lirushirealone/sensor-lossless-fpga/report/ai_collaboration.md

# 大模型协作记录

真实交互见[原话摘录](ai_records/records.md)和[结构化记录](ai_records/records.json)。共10个案例，覆盖计时归因纠错、返回复制、双缓冲所有权、世代回绕、提频失败、紧凑令牌取舍、统一候选夹具修正、CMA验收修订、跨平台源码复现和独立安装。每个案例关联可见用户指令、模型回答及实际验证证据。

摘录通过开发聊天的历史读取接口取得，包含用户提示词和对用户可见的模型原话；不是事后编写的问答，也不是完整聊天全集。私人文件引用已标注省略，账号凭据、个人升学聊天、签名及人员资料未纳入。上下文、经验提炼、验证索引为本轮整理内容，与原话分开。历史模型确切版本未在可见消息中保存，不作推断。

[evidence/collaboration/index.json](../evidence/collaboration/index.json)登记历史实验的原文件SHA256；附带历史报告和独立核验JSON保持原字节。记录中的中间数值或目标可能在后续被撤回，应以案例结论和对应测量边界为准。source-v3更新文档与技能材料；source-v4另补齐正式设计报告及小写命名，不代表重新上板或重做布局布线。

可复用技能与边界见[skill/readme.md](../skill/readme.md)。整理后的提示词模板标注为派生模板，不冒充当时原话；通用PYNQ加分是否成立仍由赛事评审判断。
