lirushirealone/sensor-lossless-fpga/report/limitations.md

# 已验证范围和限制

- 工程用于PYNQ-Z2 / xc7z020clg400-1，公开数字传感文件回放；未集成实体ADC连续采集。
- 预构建bit、RTL和固定源样本哈希可核对。历史板端验证与本轮源码包运行检查必须分别引用。
- 完整候选统一版对代表记录比旧快速版增加约29%至48%墙钟；不宣传整机加速。
- 历史新MIT-BIH/ECG-ID记录与旧55记录统计范围不同；重复回放不增加独立数据数量。
- 历史30分钟确认的本进程映射释放与RSS门槛有记录，但全局CmaFree下降2652KiB、原1024KiB阈值未通过，来源仍未完全定位。不能宣称排除所有内核泄漏。
- 原始回退保留头开销，短文件可能扩大；大块提高压缩空间也增加等待，不承诺实时性或未知输入压缩率。
- 无真实功耗、ASIC综合或PPA结果；不把资源数量当作运行忙碌率。
- 跨板卡、其他工具/系统版本未全部验证；重建需用户合法安装Vivado及PYNQ环境。
- 本包不包含正式比赛视频、签署授权书、实物照片或最终技术报告PDF；这些仍需单独完成。
