lirushirealone/sensor-lossless-fpga/report/ai_records/records.md

# 大模型协作原始交互摘录

本文件提供10个技术案例的真实用户提示词、模型可见回答和纠错过程，供评审核查。记录摘自开发聊天，属于经筛选的原始交互，不是完整聊天全集。只隐去本机文件引用；未补写、润色或重构历史原话。上下文和经验总结为2026年11月1日整理文字。消息编号、原文指纹、脱敏规则和公开文本指纹见同目录records.json。模型历史版本未在可见消息中保存，不推测具体型号。

用户多次用“知道了”启动已约定的下一阶段，这些简短提示词按原样保留，技术目标以同一案例的模型计划与后续记录补足。记录只含用户和模型对用户可见的文字，不含内部推理。历史数字保留原测量日期和口径，不能当作本轮重新上板成绩。

## c01 计时边界与未经测量的收益归因

原会话日期：2026-10-19。上下文：用户粘贴了另一AI的性能分析，要求核对；其中的数字和预测并非本项目已经确认的事实。

### 1 用户原话（用户粘贴的其他AI分析，包含后续被纠正的说法）
消息编号：`01a1532f-aa7f-7d32-90a1-63d1bae9a951`。未改写原文。

> 常规版 **direct-frame-v1**（1024 点）和最新实验 **lz77-input-v1 / lz77-hw-v2**（8192 点），v1 以及 compact-delta 之前的版本没有做分析。结论先说：**算法本身已经不是瓶颈，问题出在“搬运”上——为了搬走 5.2ms 的匹配计算，系统付出了 1.7ms 的 DMA 往返和 3.2ms 的回传再编码。**
> 
> ## 一、当前每块的实际开销（BIDMC 49 份，1568 块，8192 点/块）
> 
> | **阶段**     |  **ms/块** | **占比** | **说明**                              |
> | ---------- | --------: | -----: | ----------------------------------- |
> | 输入准备       |      3.53 |    24% | list→int16 快照 + CRC + 命令数组          |
> | DMA 往返     |      1.72 |    12% | 传输 + 缓存维护 + 轮询，**不含** FPGA 计算       |
> | FPGA 匹配    |      5.22 |    35% | 260,784 拍 @50MHz                    |
> | 令牌 Huffman |      3.16 |    21% | `lz_pack` + 32KB 令牌回传               |
> | 组帧/校验/统计   |      1.18 |     8% | metadata 两次 CRC + profile 20 次 MMIO |
> | **合计**     | **14.81** |        | 纯 ARM 对照 **10.73**                  |
> 
> 拆开 FPGA 那 5.22ms：清空头表 0.66ms（32,768 拍，占 12.6%）、125,699 次探测 2.51ms（48%）、哈希/状态机/跳过 2.05ms（39%）。
> 
> **关键对照**：纯 ARM 扣掉同样 3.53ms 的准备后是 7.20ms；FPGA 路径扣掉准备后是 11.28ms。也就是说，FPGA 搬走了 5.2ms 的匹配，却额外带来 4.9ms 的往返和二次编码——**净亏 4ms**。这正是它现在为 ARM 的 1.21～1.39 倍的真实原因。
> 
> ## 二、按性价比排序的优化项
> 
> **1. 令牌编码 3.16ms/块（最值得先动）** `lz77_pack_native.c:21,37` 每块都执行 `deflateInit2` → `_tr_flush_block` → `deflateEnd`。但这条路径只做 tally 和 Huffman，根本不做匹配，`lm_init` 里那 64KB 头表清零完全是浪费；而且每块重新 calloc 一份 \~264KB 的 deflate_state。 改法：复用一份 `deflate_state`，只重置 tally/pending（或自己维护 tally 数组直接调 `build_tree`）。另可把令牌从 4B/个改成变长 ≤2B，输出 DMA 直接减半。 预期：3.16 → 0.5～1ms，省 2～2.7s。风险低，只要保持逐字节等于现有输出（有 55 份冻结文件可以逐字节回归）。
> 
> **2. DMA 批处理，1.72ms/块** 1568 块 × 1.72ms = 2.7s 纯开销。改成 8 块一次事务（输入 128KB、令牌 ≤256KB，CMA 从 98KB 扩到 \~512KB 即可），或者直接上 SG 描述符链。 预期：2.7s → \~0.4s。代价是 RTL 要支持连续命令，现有那套 4 类故障恢复测试正好复用。
> 
> **3. 双缓冲重叠** 现在是严格串行：提交 → 等完 → 才编码。编码那 3.16ms 完全可以藏在下一块 5.2ms 的匹配后面。改完顺序流水后，单块等效时间 ≈ 准备 + max(匹配, 编码) + 帧。 预期：最多省 4.9s，是所有软件项里收益最大的一条。
> 
> **4. 头表 epoch 懒清零（RTL 小改）** `lz77_matcher.sv:141-144` 每块清 32768 项，固定 32,768 拍 = 0.66ms/块。v2 README 第 20 行自己也写了“本次未改为带 epoch 的懒清表”。给 heads 加几 bit 世代号，读时比对、不匹配当 NIL，写时打当前世代。 预期：省 12.6% 的匹配时间，输出字节完全不变。改动小、风险低，是 RTL 侧性价比最高的一项。
> 
> **5. 输入准备 3.53ms/块** `lz77_input.py:23` 的 `array.array('h', values)` 是逐元素转换；如果上游给的是 numpy 标量组成的 list，会全部走 `__index__` 慢路径（板上实测 0.43µs/点，PC 上同类操作 0.012µs/点）。真实 ADC 流本来就该是 bytes/ndarray，直接用 `<i2` 视图即可。 预期：3.53 → 0.3～0.5ms（省 5s）。**注意**：纯 ARM 对照用的是同一个 `snapshot()`，所以这项不改变“FPGA vs ARM”的结论，只是把两边绝对值一起拉低。
> 
> **6. 把时钟提上去（收益最大、工作量也最大）** 50MHz、WNS 只有 0.070ns，等于贴着时序过。关键路径几乎肯定是 8 个 bank 的 128 位组合移位 + 8 lane 比较。把 rotate 打一拍、或用 8 个 8:1 mux 替掉 barrel shift，目标 80～100MHz。 预期：按 1.4～1.7 倍折算，匹配 5.22 → 3.1～3.7ms。这条要和 1、2、3 叠加才有意义，单独做不够。
> 
> **7. 顺手能砍的测试耗时（不影响产品，但影响迭代速度）** `validate_lz77_input.py:65` 的 `sum((int(v)&0x80000000)!=0 for v in tokens)`、`lz77_protocol.expand()` 都是逐 token/逐字节的 Python。55 份记录一整轮 367s，其中真正分支时间只有 23s——15 倍都花在验证上。改成 numpy 掩码、expand 只抽样，一轮能从 6 分钟压到 1～2 分钟。
> 
> ## 三、不建议现在动的
> 
> - **降低探测预算、按历史跳过候选**：candidate-gate-v1 已经证明会改变输出字节，且收益不稳定。
> - **8192 退回 1024**：直接丢 9.6 个百分点压缩率，还把 32 位窗口优势让掉。
> - **固定 Huffman**：8192 点下波形从 61.3% 掉到 54.8%，得不偿失。
> 
> ## 四、一个更大的方向（建议下一阶段单独做）
> 
> 现在每块独立、跨块不共享历史，所以每块都要清表、也拿不到跨块匹配。改成 **16KB 滑动窗口的连续流**：8192 点不用再攒 65.5 秒才成一块（实时性解决），压缩率还能再涨一截，清表成本也自然消失。代价是匹配器位置要改成 mod 16384、令牌格式变、不能再和 zlib6 逐字节对齐——验证基准得重建。不要和本轮优化混在一起做。
> 
> ## 五、建议的执行顺序
> 
> 1. **先剖析**：在板上单独给 `lz_pack` 计时 100 次，确认那 3.16ms 到底是 C 初始化、Python/ctypes，还是 32KB 输出拷贝。
> 2. epoch 懒清表（sim 已有 237 块回归，最稳）。
> 3. DMA 8 块批量。
> 4. 双缓冲。
> 5. 输入准备。
> 6. 时钟/流水。看看其他ai给你分析的

### 2 模型可见原话
消息编号：`msg_02837f5fda74b726016ad5cec61c7887d0966cbfea72d52f72`。未改写原文。

> 我先把这份分析与现有代码、板上记录逐项核对，重点检查计时是否重叠、收益估算是否成立，再判断哪些建议值得先做。

### 3 模型可见原话
消息编号：`msg_02837f5fda74b726016ad5cf01c97887d0b461aa9e50d81516`。未改写原文。

> 核对后，逐块初始化编码器、双缓冲、清表这些优化方向有依据。但几处数字需要修正：5.22ms是FPGA整包时间，包含收数和输出；所谓1.72ms“纯DMA开销”只是两个计时区间相减，尚未单独测量。另外，按当前32位传输格式，8块批量的输入和最坏输出都会超过现有DMA单次长度上限。

### 4 模型可见原话
消息编号：`msg_02837f5fda74b726016ad5cf6d14cc87d0b471ab861c5b0415`。已隐去本机文件引用。

> 我核对了源码和原始板上记录。**这份分析提出的优化方向值得采纳，但部分计时解释、容量计算和预期收益需要纠正。最值得先做的，仍然是细分令牌编码的耗时。**
> 
> **首先，14.81ms这个总数正确，但内部不能按它的方式解释。**
> 
> 我重新汇总了49份BIDMC、1568块的记录：
> 
> | 阶段 | 平均ms/块 | 目前能确认的含义 |
> |---|---:|---|
> | 输入准备 | 3.525 | 快照、原值CRC、命令数组 |
> | DMA提交至完成 | 6.943 | **包含FPGA处理过程**，以及启动、等待等 |
> | 令牌编码调用 | 3.163 | 参数检查、C编码器、返回结果转换 |
> | 最终组帧 | 0.068 | 生成完整压缩帧 |
> | 其余驱动处理 | 1.109 | 根据总时间计算出的剩余区间，尚未进一步拆开 |
> | **完整分支** | **14.809** | 纯ARM对照为10.728 |
> 
> 依据是原始板上记录 [本机文件路径已省略]。
> 
> 这里有三个关键修正：
> 
> - **5.22ms是FPGA整包时间**，包含收数、匹配和输出；匹配器自身记录的工作时间约为 **4.69ms**。
> - **1.72ms只是“主机提交至完成时间－FPGA整包时间”**。两个计时边界不同，还没有证据把差值全部叫作纯DMA开销，更不能认为批量传输能消掉其中七分之六。
> - 纯ARM中的匹配尚未单独计时，因此“搬走了ARM的5.2ms计算”不成立。我们确认的是完整分支目前多花约 **4.08ms**，具体原因还需拆分。
> 
> 另外，8192是最大块长；这些记录包含尾块，平均约7500点/块。
> 
> **逐项看，我会这样判断。**
> 
> | 建议 | 我的判断 |
> |---|---|
> | **复用Huffman编码器状态** | **优先验证。** 每块确实重新初始化、分配和释放。可以研究复用状态，但要完整重置编码树、位缓存和输出状态，保持各块独立，不能只清两个计数器。 |
> | **压缩令牌传输格式** | 有潜力，但“每个令牌都≤2字节”不能直接保证。匹配令牌需要同时表示长度和距离，通常需要更长表示或额外上下文；这属于协议修改。 |
> | **DMA批处理** | 值得研究，但原容量估算有误，不能直接照做。 |
> | **双缓冲重叠** | **值得优先推进。** 可以让ARM编码上一块，同时让FPGA处理下一块；实际收益需计入启动、收尾和内存竞争。 |
> | **epoch懒清表** | 有明确依据，但收益上限比描述中有限，且需要处理初始化、世代号回绕和异常复位。 |
> | **输入改用ndarray/bytes** | 方向合理。当前已经有整数ndarray快路径，下一步应检查上游为何仍生成list，并让两种对照使用相同输入条件。 |
> | **提高时钟** | 可以做，须依据真实关键路径修改；80～100MHz目前只是目标。 |
> | **加快验证** | 可以优化验证实现，但正式验收应继续完整核对，不能用抽样替代全部逐点验证。 |
> 
> 其中有几个具体问题值得展开。
> 
> **1. 编码阶段还存在一个它没有明确指出的可疑开销。**
> 
> 当前返回结果使用：
> 
> ```python
> bytes(self.output[:self.size.value])
> ```
> 
> 这里对`ctypes`字节数组切片，会先形成Python整数列表，再转换成`bytes`。可以比较直接复制指定长度的字节，例如`ctypes.string_at`，避免这个中间列表。代码位置见令牌消费者 [本机文件路径已省略]，相关接口见[Python官方文档](https://docs.python.org/3/library/ctypes.html#ctypes.string_at)。
> 
> 所以，**先测清楚3.16ms分别花在初始化、实际编码和返回转换上，再决定改哪部分**。“降到0.5～1ms”目前没有实测依据。
> 
> 这3.16ms也不包含之前的DMA令牌回传，不能把两者混算。
> 
> **2. 8块批量的容量确实算少了。**
> 
> 按当前协议，输入样本虽然是16位，但每个样本占一个32位传输字：
> 
> - 8块输入：**262,176字节**。
> - 8块最坏输出：**524,544字节**。
> - 现有18位DMA单次长度上限：**262,143字节**。
> 
> 所以输入已经略超上限，输出更明显超限；输入加输出缓冲约需 **768KiB**，还没算双缓冲。需要同时调整DMA长度、协议、缓冲和恢复流程，不能只扩大CMA。
> 
> **3. 懒清表值得做，但不能承诺轻松获得很大提升。**
> 
> 每块清32768项确实耗时约 **0.655ms**。对这1568块，全部消除的理想收益约为 **1.03秒**，占完整分支约 **4.4%**。
> 
> 此外，“125,699次探测＝125,699拍”不成立：一次候选探测可能比较多个8字节窗口，**探测次数不是探测周期数**。因此它对FPGA内部时间的拆分还不是实测结论。
> 
> **4. 连续滑动窗口可以探索，但不会自动解决实时性。**
> 
> 历史窗口与输入分块可以分开设计，小批次输入也可以保留历史。要缩短等待，还需明确输出周期、动态Huffman何时结束当前块，以及解码检查点。频繁刷新输出可能损失压缩效果；跨块引用也会改变当前逐块独立解码的能力。[DEFLATE规范](https://www.rfc-editor.org/rfc/rfc1951.html#section-2)、[zlib刷新说明](https://www.zlib.net/manual.html)。
> 
> 不能提前保证压缩率一定再涨多少。
> 
> **我建议调整后的执行顺序是：**
> 
> 1. **拆分令牌编码耗时**：初始化、校验、实际Huffman、结果返回。
> 2. **先处理已确认的软件浪费**：中间列表、重复分配、可安全复用的状态。
> 3. **拆分DMA及驱动收尾耗时，实施双缓冲重叠。**
> 4. **做epoch懒清表**，单独验证效果与资源变化。
> 5. 根据剩余瓶颈，再决定批量DMA、输入格式和时钟流水优化。
> 
> 这份分析最值得采纳的是具体优化线索；**“问题已经确定全在搬运上”和各项预计节省多少秒，目前都还不能作为结论。**

### 验证与经验提炼

把整包周期、匹配工作周期、主机调用和墙钟分别定义；不能由重叠区间之差推导纯DMA开销。

证据：`evidence/collaboration/lz77-entropy-v1/report.md`；`evidence/collaboration/lz77-entropy-v1/verification.json`。

## c02 令牌返回复制与先测后改

原会话日期：2026-10-19。上下文：此前已明确先拆分令牌编码耗时；本轮“开始”是对该步骤的启动指令。

### 1 用户原话
消息编号：`01a1533a-05c5-7010-a241-396f6aa9e229`。未改写原文。

> 所以第一项就是令牌编码？如果是的，请直接告诉我，在我答复之后直接开始进行优化

### 2 模型可见原话
消息编号：`msg_02837f5fda74b726016ad5d1732d9c87d0a5f2ef495072c8f8`。未改写原文。

> 是的，先做**令牌编码环节的计时与优化**：测清结果复制、重复初始化和实际编码的耗时，再优化最贵的部分，保持压缩效果和无损校验不变。
> 
> 你回复后，我就直接开始。

### 3 用户原话
消息编号：`01a1533a-8cae-78f2-9226-4f4fcc95118e`。未改写原文。

> 开始

### 4 模型可见原话
消息编号：`msg_02837f5fda74b726016ad5d190dfac87d0aefee1a7220fc700`。未改写原文。

> 我先在板卡上拆分令牌编码的耗时，比较几种结果复制方式，再根据实测优化。新实现会放在独立版本中，并与现有压缩文件逐字节核对。

### 5 模型可见原话
消息编号：`msg_02837f5fda74b726016ad5d2831fd087d0930648dad65b9159`。未改写原文。

> 板卡已连通。我正在用之前保存的真实FPGA令牌做编码测试；这一步不需要重新加载硬件设计。除了比较复制方式，也会分别测量初始化、令牌检查、频次统计、Huffman编码和结果返回。

### 6 模型可见原话
消息编号：`msg_02837f5fda74b726016ad5d2af425087d0aa581f1a0a8a8430`。未改写原文。

> 实测发现，结果返回时生成Python列表，约占代表片段令牌编码时间的一半；初始化和释放只占很小一部分。仅改为直接复制字节，三组片段的令牌编码耗时已减少约45%～51%。我接下来把这项改动接入板上流程，核对完整压缩耗时和输出一致性。

### 7 模型可见原话
消息编号：`msg_02837f5fda74b726016ad5d44af3fc87d0ad63a44ddb5b83bb`。未改写原文。

> 电脑端55份数据已全部通过，优化前后的完整压缩文件逐字节相同。板上也正在逐份通过。此次保留原有令牌检查、编码选择和CRC，只替换结果返回方式；全量验证后，还会用新旧版本交替运行，确认完整流程实际能省多少时间。

### 8 模型可见原话
消息编号：`msg_02837f5fda74b726016ad5d50dfa1c87d0a05e3bd024580a48`。未改写原文。

> 板上55份数据已全部通过，38组边界数据和4类故障恢复也通过了。目前正在做7轮交替测速，之后会把实际输出下载到电脑独立核验，并恢复原来的常规版本。

### 9 模型可见原话
消息编号：`msg_02837f5fda74b726016ad5d579331887d0a8005bdfb21b1019`。未改写原文。

> 完整流程的7轮测速已完成：家庭电力、家电和波形三组片段的耗时分别减少13.6%、7.2%和10.9%。55份压缩文件下载后也全部核验一致。新分支仍比同条件的纯ARM慢约9.7%～22.2%；我正在保存报告，原常规版本已恢复并确认可用。

### 10 模型可见原话
消息编号：`msg_02837f5fda74b726016ad5d5b8a78487d080cfe69f8aec9929`。已隐去本机文件引用。

> **已完成令牌编码的第一轮优化，并通过上板验证。**
> 
> 主要浪费来自返回结果时生成Python整数列表。改为直接复制字节后，令牌编码耗时减少 **42.9%～49.7%**，压缩效果保持不变。
> 
> 同板7轮交替测试，完整分支结果：
> 
> | 代表片段 | 优化前 | 优化后 | 耗时减少 |
> |---|---:|---:|---:|
> | 家庭电力 | 64.12ms | 55.43ms | **13.56%** |
> | 家电 | 27.94ms | 25.93ms | **7.20%** |
> | 波形 | 66.25ms | 59.01ms | **10.93%** |
> 
> 55份数据、约1197万点全部无损还原，完整压缩文件逐字节一致；边界和故障恢复测试也通过。
> 
> 实测初始化与释放仅占原编码环节约0.9%～1.8%，因此C状态复用顺延。**新分支仍比同条件纯ARM慢约9.7%～22.2%**，下一步应细分DMA和驱动收尾成本。
> 
> 新实现保存为独立版本 `lz77-entropy-v1`，原常规版已恢复。完整实测报告 [本机文件路径已省略]

### 验证与经验提炼

微基准先定位返回列表，七轮完整分支再确认收益；初始化复用不因先验猜测进入生产路径。

证据：`evidence/collaboration/lz77-entropy-v1/report.md`；`evidence/collaboration/lz77-entropy-v1/verification.json`。

## c03 双缓冲与结果所有权

原会话日期：2026-10-19。上下文：用户按既定逐步计划回复“知道了”；随后开始双缓冲阶段。

### 1 用户原话
消息编号：`01a15400-8015-7581-95af-ec906340aa37`。未改写原文。

> 知道了

### 2 模型可见原话
消息编号：`msg_02837f5fda74b726016ad6043d42cc87d086430ea647e862e3`。未改写原文。

> 我开始下一项：双缓冲与异步调度。先确认哪些工作可以安全重叠，再让下一块的 FPGA 计算与上一块的 ARM 编码同时进行；完成板测和异常恢复验证后，我会汇报并停下。

### 3 模型可见原话
消息编号：`msg_02837f5fda74b726016ad604de677487d0972bda3782420d71`。未改写原文。

> 现有硬件一次只能处理一笔 DMA，所以这一轮不会同时启动两个压缩任务。实现上会用两组缓冲轮换：先完整取回并校验第 N 块，再启动第 N+1 块，让 ARM 趁这段时间编码第 N 块；同时检查缓冲复用和中断后的释放顺序。

### 4 模型可见原话
消息编号：`msg_02837f5fda74b726016ad6063ea93487d0a26d529f164b9efa`。未改写原文。

> 电脑端已通过 10 组调度与生命周期测试，包括禁止重复提交、旧结果在缓冲复用后仍有效、编码或输出出错时取消后续任务。55 份数据的完整文件比对也通过了。现在正做小规模板测，确认真实 DMA 下的重叠和恢复行为。

### 5 模型可见原话
消息编号：`msg_02837f5fda74b726016ad606fcd70887d085d7e7fb75e84b7c`。未改写原文。

> 小规模板测通过了：三种调度方式生成的文件完全一致，也实际观察到了“下一笔 DMA 尚未完成，ARM 已开始编码上一块”。重叠版暂时比串行版快，但首块输出略晚；完整板测会同时记录吞吐、首末块延迟，以及双缓冲增加的内存占用。

### 6 模型可见原话
消息编号：`msg_02837f5fda74b726016ad607f6bcc087d0b28c37710f12a4b3`。未改写原文。

> 55 份真实数据已经全部通过，压缩结果没有变化。现在正在验证新增的流水异常场景，包括编码失败、输出回调失败和中断时取消下一笔 DMA。之后会用相同输入比较旧串行、拆分接口后的串行，以及双缓冲重叠三种方式，区分接口开销和重叠带来的收益。

### 7 模型可见原话
消息编号：`msg_02837f5fda74b726016ad608c0b51887d090f749872f1d2a31`。未改写原文。

> 独立核验通过了。双缓冲让三个代表记录的完整流程耗时再减少 **18.74%～22.01%**；其中 `bidmc01` 波形记录比同条件纯 ARM 少用约 **12.1%** 时间，另外两类仍慢于 ARM。压缩文件字节保持不变，代价是多用约 96 KiB 缓冲，首块输出晚约 1 ms。

### 8 模型可见原话
消息编号：`msg_02837f5fda74b726016ad608f7251487d0be2da2d4893f1164`。已隐去本机文件引用。

> **双缓冲与异步调度已完成，并通过板测。**现在 FPGA 处理下一块时，ARM 同时编码上一块。
> 
> 同板七轮测试，三个完整代表记录的耗时：
> 
> | 数据 | 原串行 | 双缓冲 | 耗时减少 |
> |---|---:|---:|---:|
> | 家庭电力 | 57.27 ms | 45.59 ms | 20.39% |
> | 家电 | 49.68 ms | 40.37 ms | 18.74% |
> | 波形 | 335.47 ms | 261.62 ms | 22.01% |
> 
> 波形代表记录已比同条件纯 ARM **少用约12.1%的时间**；另外两类仍慢于 ARM。
> 
> 55份数据、约1197万点核验通过，**压缩文件字节不变**。代价是增加约96 KiB缓冲、首块输出晚约1 ms。已恢复常规设计。
> 
> 完整报告 [本机文件路径已省略]
> 
> 本轮停下，等你回复“知道了”再开始下一项。

### 验证与经验提炼

提交下一块前保留上块自有结果，任何消费者或输出故障必须取消下一笔DMA，复位确认后再释放。

证据：`evidence/collaboration/lz77-pipeline-v1/report.md`；`evidence/collaboration/lz77-pipeline-v1/verification.json`。

## c04 世代标签与回绕清表

原会话日期：2026-10-19。上下文：本轮为已约定顺序中的头表清零优化，不把“知道了”改写成一段事后设计的提示词。

### 1 用户原话
消息编号：`01a15458-2eea-7e91-8449-1c4715614657`。未改写原文。

> 知道了

### 2 模型可见原话
消息编号：`msg_02837f5fda74b726016ad61ab38cfc87d0ac16f1b20c48d181`。未改写原文。

> 我开始下一项：优化每块启动前的哈希头表清空开销。先设计用“世代标签”识别旧数据的方案，再验证标签回绕、复位和异常恢复，确保压缩结果不变。完成后我会汇报并停下。

### 3 模型可见原话
消息编号：`msg_02837f5fda74b726016ad61b43f2b087d080493fcb573bd752`。未改写原文。

> 方案已经确定：给每个头表项加 4 位标签，标签不属于当前块时，就按空项处理。冷启动、复位后，以及标签循环用尽时，仍完整清表一次。这样既能省掉大多数清表过程，也能防止旧数据重新被误用；实际资源和时序还要经过综合确认。

### 4 模型可见原话
消息编号：`msg_02837f5fda74b726016ad61ceea5ec87d0b38c9978eaf0c0d2`。未改写原文。

> 301 个压缩核心测试已在三组等待模式下通过，令牌和搜索次数都与原版一致。逐块计数也确认：普通块恰好少 32,768 个工作周期，冷启动和回绕块仍完整清表。初步综合显示会增加少量块 RAM，接下来确认完整设计的资源和时序。

### 5 模型可见原话
消息编号：`msg_02837f5fda74b726016ad61d895ca887d08184a8b907a29159`。未改写原文。

> 完整 AXI 链路的 134 块测试也全部通过了，包含多次标签回绕、背压和复位，输出包逐字节一致。Vivado 正在生成完整设计并检查 50 MHz 时序；通过这个检查后，再上板测完整流程的实际收益。

### 6 模型可见原话
消息编号：`msg_02837f5fda74b726016ad61eccbde087d09e3ab1f4b3eed3ec`。未改写原文。

> 完整设计已通过 50 MHz 布局布线，资源增加为 **50 个 LUT、3 个寄存器和4个等效块RAM**，时序检查通过。接下来上板跑55份数据，并专门测试标签从15回到1时被中断、重载后能否正确恢复。

### 7 模型可见原话
消息编号：`msg_02837f5fda74b726016ad61f2c1e8c87d0b51c77e217d6c04e`。未改写原文。

> 新设计已上板，双缓冲的所有权、非法输入拒绝、关闭保护和延迟取回结果的检查已通过。软件沿用上一轮版本，后面的新旧比较只更换 FPGA 设计，这样能单独看出本次硬件改动的收益。

### 8 模型可见原话
消息编号：`msg_02837f5fda74b726016ad61fe62fcc87d0b54965a2e85c90b8`。未改写原文。

> 55份真实数据和134个边界块都已通过，压缩结果与参考一致。接下来完成故障恢复和回绕中断专项；性能比较会同时计入定期完整清表的块，避免只看跳过清表时的最好情况。

### 9 模型可见原话
消息编号：`msg_02837f5fda74b726016ad62055c41487d086f3883baacfe733`。未改写原文。

> 全部板测、11类故障恢复、回绕中断后的重载测试，以及七轮新旧比较都已完成。常规设计也已恢复并实际验证。最后正在电脑端核对完整文件，并逐块检查周期差：普通块应少32,768拍，冷启动和回绕块应保持不变。

### 10 模型可见原话
消息编号：`msg_02837f5fda74b726016ad620c3395887d0af690ed3df23bcc6`。未改写原文。

> 独立核验全部通过：三个代表记录的完整流程耗时减少 **5.64%～9.37%**，七轮比较均有改善；压缩文件逐字节不变。真实数据中的普通块都恰好少32,768拍，冷启动和回绕块保留了完整清表，回绕中断后的恢复也通过了。本轮结果正在保存，随后停下。

### 11 模型可见原话
消息编号：`msg_02837f5fda74b726016ad620ff49c087d083c264e439d40d7c`。已隐去本机文件引用。

> **本项已完成：FPGA世代标签头表优化。**多数数据块省去了重复清表，压缩结果不变。
> 
> 同板本轮七轮测试中位数：
> 
> | 数据 | 优化前 | 优化后 | 耗时减少 |
> |---|---:|---:|---:|
> | 家庭电力 | 44.81 ms | 42.28 ms | 5.64% |
> | 家电 | 40.54 ms | 36.74 ms | 9.37% |
> | 波形 | 259.40 ms | 241.30 ms | 6.98% |
> 
> 代价是增加 **50个LUT、3个寄存器和4块BRAM**，频率仍为50 MHz。
> 
> 55份数据、约1197万点核验通过，文件逐字节不变；冷启动、标签回绕和中断恢复均通过，已恢复常规设计。
> 
> 完整报告 [本机文件路径已省略]
> 
> 本轮停下，等你回复“知道了”再继续。

### 验证与经验提炼

普通块可省清表，但冷启动、复位和标签回绕必须清表；设备省拍不直接等于墙钟省时。

证据：`evidence/collaboration/lz77-epoch-v1/report.md`；`evidence/collaboration/lz77-epoch-v1/verification.json`。

## c05 提频失败与实际时钟选择

原会话日期：2026-10-20。上下文：模型提出流水与提频，用户同意继续；保留目标未通过时序及降低目标的过程。

### 1 用户原话
消息编号：`01a158a9-281a-7983-8ac0-98055d94c3a1`。未改写原文。

> 知道了

### 2 模型可见原话
消息编号：`msg_02837f5fda74b726016ad735a19f8887d08a1de341763530f4`。未改写原文。

> 我开始下一项：关键路径流水与频率优化。先检查当前设计中最慢的电路路径，再试着增加流水级，比较频率收益和新增周期的代价。只有仿真、时序和板测都通过才保留改动；完成后我会汇报并停下。

### 3 模型可见原话
消息编号：`msg_02837f5fda74b726016ad73677aeb487d080786222e2e9bc77`。未改写原文。

> 关键路径已经确认：它从存储器读出数据，连续完成字节比较、匹配长度计算和长度修正，留给时序的余量很小。我会先简化字节比较逻辑，并把最后的长度修正单独放一拍，验证能否提高频率，同时保持压缩结果不变。

### 4 模型可见原话
消息编号：`msg_02837f5fda74b726016ad737bda7c487d0b78f9807f0636b97`。未改写原文。

> 核心的301组测试和完整接口的134组测试，都已在三种等待条件下通过。时钟配置还有一个实际限制：请求80MHz后，板卡分频器生成的是约76.92MHz。我会按实际频率核算收益，并检查这个频率下能否通过时序。

### 5 模型可见原话
消息编号：`msg_02837f5fda74b726016ad73921663487d09fbf4e0572cac55c`。未改写原文。

> 第一版未通过时序，已经排除。报告定位到新的瓶颈：下一次预取地址仍要等当前字节比较结束后才能计算。我会利用“每次继续比较固定前进8字节”这一规则提前计算地址，再重新验证；这一步不改变搜索结果，也不增加比较拍数。

### 6 模型可见原话
消息编号：`msg_02837f5fda74b726016ad739e208d487d0a68eb74011b9d3f1`。未改写原文。

> 预取地址改动已重新通过全部仿真，工作拍数与第一版一致，说明这次调整没有再增加周期成本。现在正在重新综合和布线；通过后还要做完整数据回归与七轮新旧硬件配对测试，才能确认收益。

### 7 模型可见原话
消息编号：`msg_02837f5fda74b726016ad73b6fe94487d08b9f69dca5e1616e`。未改写原文。

> 第二版把原先的预取路径缩短了，剩余限制转移到了Adler校验电路，76.92MHz仍未通过时序。我会用66.67MHz重新实现并验证。这比原来的50MHz高约33%，但完整处理能快多少，还要以板测为准。

### 8 模型可见原话
消息编号：`msg_02837f5fda74b726016ad73d254f8c87d0a7f723122be3f015`。未改写原文。

> 66.67MHz版本已通过完整布局布线，setup/hold余量为0.060/0.025纳秒。资源变化很小：LUT从5318变为5327，BRAM仍为36块等效。现在开始上板验证全部55份数据，并测七轮完整处理耗时。

### 9 模型可见原话
消息编号：`msg_02837f5fda74b726016ad73ed5f14087d0b1f147d73536a1c5`。未改写原文。

> 电脑上的独立核验也已通过。七轮配对结果显示，三个代表记录的完整处理耗时分别减少约11.1%、15.4%和16.0%，压缩文件字节保持不变。正式版本已经恢复；我正在保存本轮报告和复现清单，完成后停下。

### 10 模型可见原话
消息编号：`msg_02837f5fda74b726016ad73f1ede7887d08305bf4c0fa644b1`。已隐去本机文件引用。

> 本轮优化已完成并上板验证。**LZ77实验分支从50MHz提高到66.67MHz，压缩文件字节保持不变。**
> 
> 七轮配对测试的完整处理耗时中位数：
> 
> | 代表数据 | 优化前 | 优化后 | 耗时减少 |
> |---|---:|---:|---:|
> | 家庭电力 | 42.62ms | 37.89ms | 11.10% |
> | 家电 | 36.40ms | 30.79ms | 15.41% |
> | 波形 | 240.60ms | 202.11ms | 16.00% |
> 
> 更高频率未通过时序，因此采用66.67MHz。全部55份、约1197万点通过无损核验，故障恢复测试通过，常规版本已恢复。
> 
> 完整报告 [本机文件路径已省略]
> 
> 本轮停在这里，等你回复“知道了”再继续下一项。

### 验证与经验提炼

按完整布局布线和实际分频选择时钟，失败目标不能作为已实现成果；功能回归还须覆盖新增流水状态中的复位。

证据：`evidence/collaboration/lz77-clock-v1/report.md`；`evidence/collaboration/lz77-clock-v1/verification.json`。

## c06 紧凑令牌减少传输却增加ARM成本

原会话日期：2026-10-20。上下文：本轮先比较紧凑令牌与DMA调用成本，再决定是否改硬件协议。

### 1 用户原话
消息编号：`01a159db-f855-7882-a0fe-8509f4081004`。未改写原文。

> 知道了

### 2 模型可见原话
消息编号：`msg_02837f5fda74b726016ad784283c1087d09c0e84ba735d043d`。未改写原文。

> 我开始下一项：先测清令牌的数据量和DMA的固定开销，再决定优先做紧凑令牌还是批量传输。两种方案会分开评估，保留现有压缩效果和校验能力；完成这一项后汇报并停下。

### 3 模型可见原话
消息编号：`msg_02837f5fda74b726016ad784db4fbc87d0b53e74a738d4b2c3`。未改写原文。

> 发现了一个关键点：55份实测里，FPGA输出都没有因DMA接收而停顿。令牌确实可以缩小，按一种分组格式估算，回传量可减少约48%；但这不等于整机能同比提速。接下来会测主机启动、缓存处理和紧凑令牌解码的成本，判断是否值得改接口。

### 4 模型可见原话
消息编号：`msg_02837f5fda74b726016ad78658e7ac87d08c5827d00a248042`。未改写原文。

> 两种紧凑格式的参考编解码已通过全部1614个压缩块的往返验证，原始令牌完全一致。接下来会在板上测它们增加的ARM解码开销，并细分现有DMA调用的耗时；这些测量会与正常运行计时分开。

### 5 模型可见原话
消息编号：`msg_02837f5fda74b726016ad7873e242887d0bfbb79964284797f`。未改写原文。

> 测量程序已在板上运行，仍使用上一轮通过验证的66.67MHz设计。我会先比较正常运行与加入计时记录后的差异，确认计时本身带来的干扰，避免把测量开销误判成系统瓶颈。

### 6 模型可见原话
消息编号：`msg_02837f5fda74b726016ad78830135c87d092521b573b0734c8`。未改写原文。

> 实测显示：缓存同步主要有固定调用成本，少传一半字节并不会让它明显变快；而当前紧凑格式原型需要先还原成32位令牌，再交给Huffman编码，这增加了ARM开销。因此现在不宜直接改紧凑接口，我会把它与DMA启动成本、批量容量限制一起整理成结论。

### 7 模型可见原话
消息编号：`msg_02837f5fda74b726016ad789b4865c87d09291da5c28391e11`。未改写原文。

> 独立核验已通过。本轮结论是：先保留32位令牌，下一步优先验证2块小批量DMA，暂缓把紧凑格式接入FPGA。紧凑草案可减少约48%的令牌回传量，但当前ARM回放中的解码加编码耗时增加约27%～35%，尚不能证明有整机收益。正式版本已恢复，我保存报告后停下。

### 8 模型可见原话
消息编号：`msg_02837f5fda74b726016ad789e9814c87d09286b57c8c0e6ef9`。已隐去本机文件引用。

> 本轮成本评估已完成。**下一步优先做2块小批量DMA，保留原32位令牌。**
> 
> 紧凑格式草案可减少约48%的令牌回传量，但当前ARM回放中的“解码＋编码”耗时反而增加约27%～35%，尚未证明有整机收益。因此暂缓接入FPGA。
> 
> 原型验证、880个原协议实际包及恢复检查通过，常规版已恢复。本轮属于评估，实际接口保持原版。
> 
> 完整报告 [本机文件路径已省略]
> 
> 停在这里，等你回复“知道了”再开始2块批处理。

### 验证与经验提炼

回传体积减少不是最终文件节省或整机加速；记录测量插桩干扰、解包代价与最坏BTT容量。

证据：`evidence/collaboration/lz77-transport-study-v1/report.md`；`evidence/collaboration/lz77-transport-study-v1/verification.json`。

## c07 统一候选与对照夹具纠错

原会话日期：2026-10-21。上下文：本轮将既有小块和大块引擎统一；期间发现冻结参考覆盖不足及通道序号比较边界错误。

### 1 用户原话
消息编号：`01a15bc3-e661-7b03-a8c5-b893a7696225`。未改写原文。

> 知道了

### 2 模型可见原话
消息编号：`msg_02837f5fda74b726016ad80104f98087d08afedd0d0226df0a`。未改写原文。

> 我开始整合正式版本。这一轮会把Rice、LZ77、候选择优、原始回退和解码入口统一起来，再做仿真与板上核验；完成后汇报并停下，暂不进入界面制作。

### 3 模型可见原话
消息编号：`msg_02837f5fda74b726016ad801550f7087d0b45bb08eccb70033`。未改写原文。

> 整合时会保留两种块长：Rice继续处理1024点小块，LZ77处理最多8192点大块，再比较同一段原始数据的完整输出大小。这样能保留小块预测的优势，也不会把两种块长的成绩混在一起比较。

### 4 模型可见原话
消息编号：`msg_02837f5fda74b726016ad802cdf9a887d0a3a655846be2163e`。未改写原文。

> 两种核心的并行仿真已通过。统一设计会让它们同时驻留在板卡中，各自保持已验证的频率。旧版1024点的小块择优也会保留，作为新大块方案的候选，避免遇到混合数据时压缩效果反而下降。

### 5 模型可见原话
消息编号：`msg_02837f5fda74b726016ad80445f46487d0b18443c764195357`。未改写原文。

> 统一入口和文件格式已写好，12组新增测试通过了，包括原始回退、短尾块、数据源复用缓冲、文件损坏，以及出错时同时停止两路DMA。现在还在做完整硬件实现，随后会用55份真实数据核对最终结果和实际代价。

### 6 模型可见原话
消息编号：`msg_02837f5fda74b726016ad805b68f8487d0bc56ce94ae953e3c`。未改写原文。

> 统一硬件已通过完整布线和时序检查。现在同一份设计中已有四路Rice核心和LZ77核心，并移除了最终路径不再使用的预测成本模块。接下来开始板上全量验证，重点核对双引擎同时运行、完整文件择优和两路故障恢复。

### 7 模型可见原话
消息编号：`msg_02837f5fda74b726016ad8068f430087d0bc89aa0c60caca74`。未改写原文。

> 整合路径已跑通前10份记录，随后测试夹具发现：旧板测只保存了这10份原生候选，不能直接当作55份的完整对照。我会补齐其余记录的冻结参考并逐点核对，再继续全量验收；板卡已自动恢复到原常规版。

### 8 模型可见原话
消息编号：`msg_02837f5fda74b726016ad807af3da087d0aba734c93429f753`。未改写原文。

> 55份真实数据现在已全部通过统一版验证，两路硬件都实际参与了计算，压缩结果没有失去旧小块方案或大块方案的尺寸优势。正在完成故障重载和交替计时；下一步会在电脑上独立复核下载的证据，再切换默认入口。

### 9 模型可见原话
消息编号：`msg_02837f5fda74b726016ad80836386087d0b8bb75167bd5cf7c`。未改写原文。

> 全量无损检查和九类双引擎故障恢复都已通过。对照计时夹具还需要修正一处：旧版跨文件延续通道序号，而参考文件从1开始，所以直接比字节会误报。我会保留已有55份板测证据，修正对照后继续计时。

### 10 模型可见原话
消息编号：`msg_02837f5fda74b726016ad8093f36e887d0b9782a0f1ccd2aa0`。未改写原文。

> 对照比较已修正，多轮测试正在正常完成。统一版保留了更多候选，这些计算也会增加成本；最终会以整个文件的实际耗时和大小判断收益，不把单个LZ77核心的成绩当作完整系统成绩。

### 11 模型可见原话
消息编号：`msg_02837f5fda74b726016ad809dd2bb887d09590f85f2ddeec80`。未改写原文。

> 板上结果已出来：完整文件的空间节省约为电力55.08%、家电79.57%、波形61.31%。代价也很明确：保留两套完整候选后，目前比旧常规版慢约29%～48%。这轮完成了系统整合，但还不能称为整机加速；旧版会保留供回退。

### 12 模型可见原话
消息编号：`msg_02837f5fda74b726016ad80a5c22d487d094ed58e74eaca986`。未改写原文。

> 电脑独立复核和命令入口的压缩、解压往返都已通过。统一版已重新加载到板卡，并用完整电力记录确认了输出和两路DMA状态。现在整理版本清单；完成后会停下，下一阶段再做独立数据和长时间稳定性测试。

### 13 模型可见原话
消息编号：`msg_02837f5fda74b726016ad80ac6647c87d0906584b9401a3a98`。已隐去本机文件引用。

> 这一阶段已完成：**Rice、LZ77、候选择优和解压已统一，板卡已切换到统一版。**55份数据全部无损通过。
> 
> 本批数据的空间节省为：电力 **55.08%**、家电 **79.57%**、波形 **61.31%**。但完整比较使耗时比旧版增加约 **29%～48%**，旧版已保留供回退。
> 
> 还剩3个阶段：
> 
> 1. 独立数据与长时间稳定性测试。
> 2. 电脑操作界面。
> 3. 提交材料、演示与复现。
> 
> 本轮完整报告 [本机文件路径已省略]已保存。我先停下，等你回复“知道了”再继续。

### 验证与经验提炼

补齐完整参考并修正对照夹具，不修改已验证算法来迎合错误测试；空间收益和整机时间代价分别报告。

证据：`evidence/collaboration/unified-v1/report.md`；`evidence/collaboration/unified-v1/verification.json`。

## c08 独立数据与CMA验收修订

原会话日期：2026-10-21。上下文：本轮先固定九份新记录，再做完整长跑；保留原全局CMA门槛失败及重新开始的确认试验。

### 1 用户原话
消息编号：`01a15bea-56d4-7790-b19f-8a0b4eb8799a`。未改写原文。

> 知道了

### 2 模型可见原话
消息编号：`msg_02837f5fda74b726016ad80adc7ecc87d083a95cdd083dec2d`。未改写原文。

> 我开始做独立数据和长时间稳定性验收。这轮会先固定未参与前期优化的数据，再测试连续运行、不同通道组合、慢速供数及异常恢复，完成后汇报并停下。

### 3 模型可见原话
消息编号：`msg_02837f5fda74b726016ad80b7175b087d092faeb1ad6da6c48`。未改写原文。

> 这一轮会固定新数据和验收规则，再观察压缩结果；同时连续运行正式版本，检查逐点还原、内存变化和异常后的恢复。不会因为某组数据压缩效果差就把它剔除。

### 4 模型可见原话
消息编号：`msg_02837f5fda74b726016ad80bcc01a487d09225e67c1fb979d0`。未改写原文。

> 新数据已固定为 MIT-BIH 的前3份记录，以及 ECG-ID 前6人的首份记录，全部保留，不裁剪、不重新缩放。这能补充波形数据的独立验证；电力方向仍沿用原有回归数据，不能据此扩大结论。[MIT-BIH](https://physionet.org/content/mitdb/1.0.0/)、[ECG-ID](https://www.physionet.org/content/ecgiddb/1.0.0/)

### 5 模型可见原话
消息编号：`msg_02837f5fda74b726016ad80d9abcbc87d09aad61b7a5898062`。未改写原文。

> 9份新记录已通过官方文件哈希和原始采样校验，板级验收已启动。MIT-BIH 原文件使用12位打包存储，我们的接口使用16位整数；报告会同时列出这两种基准下的空间节省，避免数字产生误导。

### 6 模型可见原话
消息编号：`msg_02837f5fda74b726016ad80feb8a8087d0834350277a5b1776`。未改写原文。

> 加速后的校验器已在电脑和板卡上，与原校验器核对了1,395帧，覆盖全部5种原生编码模式，结果逐点一致。完整验收已重新开始；第一次慢速尝试的记录保留在单独目录中。

### 7 模型可见原话
消息编号：`msg_02837f5fda74b726016ad81296dab487d0aecca841caa47f29`。未改写原文。

> 连续运行已超过8分钟、核对约1.72亿个采样值，尚无数据错误。进程常驻内存保持在约84MiB，但系统空闲连续内存持续下降；内存验收这一项还需要查清原因，目前不能宣布稳定性全部通过。

### 8 模型可见原话
消息编号：`msg_02837f5fda74b726016ad812f559d887d0ba4765ff34d86f7a`。未改写原文。

> 已确认当前进程仍只有8个 DMA 映射，合计512KiB；全系统的 `CmaFree` 无法单独说明这些缓冲是否泄漏。我会保留本次记录，增加实际映射、地址稳定性及关闭后释放的检查，再重新跑满30分钟。这个调整只涉及验收方法。

### 9 模型可见原话
消息编号：`msg_02837f5fda74b726016ad8140fd69c87d0b8880f5210053bfc`。未改写原文。

> 新的30分钟确认试验已开始：两轮热身后重新计时，不拼接前一次的时间。每个周期都会核对8个 DMA 映射、物理地址及映射大小；结束时还要检查关闭后是否全部释放。全系统空闲CMA仍会记录，但不会再把它等同于本进程分配量。

### 10 模型可见原话
消息编号：`msg_02837f5fda74b726016ad81af53b2487d0a9f5388a7458777b`。未改写原文。

> 30分钟确认试验已完成：累计6.23亿个采样值核对无误，8个DMA映射关闭后全部释放。正式版本也已由新进程重新加载并实跑通过。我正在做最后的电脑端日志和冻结文件核验。

### 11 模型可见原话
消息编号：`msg_02837f5fda74b726016ad81b6a307487d0842f66e9238be08e`。已隐去本机文件引用。

> 本轮验收已完成：
> 
> - 原55份回归、新9份数据，全部逐点无损通过。
> - 连续回放30分钟，累计核对6.23亿个采样值，无数据错误。
> - 8个DMA映射保持固定，关闭后全部释放；正式版本已恢复。
> 
> 系统空闲CMA下降的原因尚未完全确认，测量修订与限制已写入验收报告 [本机文件路径已省略]。
> 
> **还剩2步：电脑操作界面；提交材料、演示与复现。**我先停下，等你回复“知道了”再做界面。

### 验证与经验提炼

全系统CmaFree与本进程映射分开观察，撤回旧门槛须保留记录并重新跑完整窗口，不能拼接或宣称已排除所有内核泄漏。

证据：`evidence/collaboration/unified-validation-v1/report.md`；`evidence/collaboration/unified-validation-v1/verification.json`。

## c09 源码独立复现与跨系统换行

原会话日期：2026-10-31。上下文：用户要求独立整理比赛源码；验证发现完成顺序、换行和中文父目录处理问题。

### 1 用户原话
消息编号：`01a18fab-1588-7832-a4c5-812c206f9914`。未改写原文。

> 单独整理比赛源码包和GitHub仓库

### 2 模型可见原话
消息编号：`msg_0b23902faeccad33016ae54d8f6e34819197b9dd72f5417b1b`。未改写原文。

> 源码已抽取成独立比赛目录，包含最终 RTL、板端驱动、桌面界面、三组示例数据和参考压缩结果。现在正在补齐从零运行说明，并验证软件测试、RTL 仿真和发布前检查。

### 3 模型可见原话
消息编号：`msg_0b23902faeccad33016ae5502d02bc819197a1f4e1cf94102c`。未改写原文。

> 独立源码目录已整理好，软件测试已通过。发布前检查发现两处验证脚本需要核实：令牌编码的对照方式，以及 RTL 输出的比较方式。我会先查清差异，确认源码包脱离旧实验目录后仍可复现。

### 4 模型可见原话
消息编号：`msg_0b23902faeccad33016ae550aa959c819198bf1611e83409a4`。未改写原文。

> 已确认差异来自新验证脚本：并行通道的完成顺序会随等待变化，计时计数也会变化；稳定的编码内容需要单独比较。修正后，134 个原生编码测试已通过。板卡目前在线，我会用独立源码目录再跑三组示例，确认它不依赖旧工程。

### 5 模型可见原话
消息编号：`msg_0b23902faeccad33016ae5510a6cdc8191aece167102e4d992`。未改写原文。

> 三组随机背压 RTL 仿真已通过。新目录的第一次板测在压缩后被桌面端拦下，提示运行清单或源数据的哈希不一致；我正在核对具体字段。在通过全量比对前，这次结果不会标记为成功。

### 6 模型可见原话
消息编号：`msg_0b23902faeccad33016ae5518f1b608191aa582cacc3fa062b`。未改写原文。

> 已定位到板测拦截的原因：新适配器传输清单时保留了 Windows 换行，而校验端按 Linux 换行计算哈希。已修正适配器，原算法和位流保持一致，正在重跑。GitHub 连接器没有创建仓库的功能，建仓环节需要使用浏览器。

### 7 模型可见原话
消息编号：`msg_0b23902faeccad33016ae551c4332c8191bca4f799b9b28069`。未改写原文。

> 独立源码版已在板卡上跑通三组示例，共 **314,034 个采样点**，压缩文件与原正式版本逐字节一致。19 个历史冻结阶段和原软件的 4,759 个文件也都保持原样。接下来生成 RAR，并从解压后的副本再次检查。

### 8 模型可见原话
消息编号：`msg_0b23902faeccad33016ae5527466b88191b843dd1e800fccb2`。未改写原文。

> RAR 解压后的软件测试已通过；首次编译检查又发现，原生 C 构建脚本不能正确处理中文父目录。这个问题只影响源码复现。我会修复源码版的构建路径处理，再重打包验证，原桌面软件继续保留。

### 验证与经验提炼

比较稳定编码内容而非并行完成顺序或计时字段；清单按实际字节传输并核验，在独立目录首次运行。

证据：`evidence/release_checks.json`。

## c10 唯一GUI与独立安装环境

原会话日期：2026-11-01。上下文：用户要求只保留最新GUI，并提供不依赖原电脑路径的安装入口。

### 1 用户原话
消息编号：`01a19570-c70b-7c70-8ee2-79259300bedd`。未改写原文。

> 这个runtime里怎么有三个版本的桌面gui？只保留最新的，所有源码包都只要最新的内容，并且在源码包的目录里生成一个文件，运行后可以直接安装软件（不依赖于特定的电脑，这个文件要通用）

### 2 模型可见原话
消息编号：`msg_0b23902faeccad33016ae6c4cf55e08191bd3df2774b539f84`。未改写原文。

> 我会检查源码包和 runtime 中的三个桌面 GUI，确认最新入口后移除旧版内容，并在源码包根目录加入通用安装入口，再验证安装和启动流程。

### 3 模型可见原话
消息编号：`msg_0b23902faeccad33016ae6c550838c8191bd9ce2998eb85c17`。未改写原文。

> 这三个目录并非完全独立的版本：最新版仍从前两版导入了数据读取、板卡处理和关机功能。我会把这些仍在使用的功能合并成一个 `desktop_gui` 目录。安装入口将面向 Windows 10/11 64位电脑，自动准备独立运行环境并创建快捷方式；首次安装需要联网。

### 4 模型可见原话
消息编号：`msg_0b23902faeccad33016ae6c7d609f08191bcc543435a17864e`。未改写原文。

> 独立安装测试已通过：安装器自行下载了 Python 和11项固定依赖，没有调用原电脑的 Python。合并后的界面完成了三份示例共314,034点的逐点核验，并通过导入、解压及关机检查流程。接下来验证源码包换位置后安装、重复安装和历史文件保留，再更新源码包与 GitHub。

### 5 模型可见原话
消息编号：`msg_0b23902faeccad33016ae6c9708ac08191b2e27d9d32267ecc`。未改写原文。

> 换位置安装、移走原源码后启动、重复安装保留历史，以及损坏文件拒绝测试均已通过。源码中的 GUI 已合并为一个目录；98份算法、驱动、RTL、位流和构建文件逐字节未变。现在重新生成并校验压缩包，随后同步提交目录和 GitHub。

### 验证与经验提炼

先识别旧目录仍被依赖的功能再合并；用新下载的环境验证移位安装、移走原源码、重复安装与历史保留。

证据：`evidence/release_checks.json`。
