lirushirealone/sensor-lossless-fpga/evidence/collaboration/lz77-clock-v1/report.md

# 第6轮：关键路径分段与实际频率优化

2026-10-20，以电脑日期为准。隔离版本lz77-clock-v1；只完成当前一项，汇报后停止，等待用户“知道了”。正式入口仍为direct-frame-v1；独立8192点LZ77/DEFLATE候选尚未接回Rice与最终竞赛调度。

## 实际改动

上一版50MHz最慢路径从字节BRAM读口经过窗口旋转、前缀长度、匹配长度比较及lookahead/远距离修正，到match_length。新版用8个并行字节相等位与前缀优先编码替换串行递增逻辑；比较索引从0每次增加8，索引256时将前缀截为最多2字节，精确保留258字节匹配上限。

链搜索退出时先寄存best_length/match_start，新增FINAL_LENGTH状态完成长度截断和距离过滤。每次完成一次位置搜索多1拍；不是每个探测或每个8字节窗口都多1拍。当前8bank预取、搜索预算、延迟匹配/相等选择、世代头表、冷启动/回绕扫描、令牌与完整输出保持。

继续比较固定增加8，索引低3位恒零；下一窗口与下一链候选的各bank字地址分别提前完成算术，当前字节比较只控制最后的地址选择，切断RAM输出至预取加法/进位的长反馈。第一版缺少该地址改动，在实际76.92308MHz布线setup为-2.980ns，被拒绝且未上板；原始源码与报告保存在rejected-attempt-1。

预取调整后的第二次80MHz请求同样实际生成76.92308MHz，布线setup仍为-0.898ns，限制转移到前端Adler32校验路径。这次也拒绝并未上板，证据保留在rejected-attempt-2。较高频率的失败是选择最终频率的依据，不是已验证的运行结果。

最终Vivado请求66.66666700MHz，PS7实际分频得到66.66667200MHz；HWH、分频[5, 3]和布局布线14.999ns周期一致，板上实际读取为66.66666700MHz。没有达到80～100MHz目标，不能把请求值当实测。新版以实际频率通过setup/hold，余量为0.060/0.025ns。

## 相同软件的七轮交替整流比较

比较旧世代头表50MHz与新流水硬件。1轮热身排除＋7轮交替，每个硬件加载后先处理同一热身块；三个完整代表记录含尾块，分别8、6、32块。两边使用相同紧凑数组、自有快照、两槽重叠、驱动/统计、CRC、自适应固定/动态Huffman、完整24字节帧和回退；ARM对照同样使用紧凑输入。variant字段epoch代表本轮新版，不是仍运行旧50MHz设计。

时间直接测源迭代器至内存sink返回，包含分块、输入准备、DMA/FPGA、收包/统计、编码及帧。Overlay加载、数据加载、写盘、独立参考和解码在外；活动块之间不运行参考。DMA提交至观察完成包含重叠的ARM编码，不是纯搬运，不能把这些计时相加。

| 记录 | 旧50MHz完整ms | 新版完整ms | 耗时减少 | 更快轮数/7 | 新版/同轮ARM耗时 |
|---|---:|---:|---:|---:|---:|
| 家庭电力 | 42.622 | 37.891 | 11.10% | 7 | 1.068× |
| 家电/照明 | 36.400 | 30.791 | 15.41% | 7 | 0.856× |
| 波形 | 240.603 | 202.109 | 16.00% | 7 | 0.690× |

比值小于1才表示该记录在此计时边界快于ARM；不能外推所有输入、实体采集或每次运行。各轮独立测量，不与先前隔时刻结果相减，也不累加前几轮收益。

| 记录 | 七轮耗时减少范围 | 旧窗口首块ms | 新窗口首块ms | 新末次提交至结束ms | 新原始输入吞吐MiB/s |
|---|---:|---:|---:|---:|---:|
| 家庭电力 | 7.64%～12.20% | 11.479 | 10.353 | 3.371 | 1.740 |
| 家电/照明 | 12.63%～16.54% | 11.899 | 10.260 | 3.556 | 2.445 |
| 波形 | 15.49%～18.21% | 11.939 | 10.388 | 4.499 | 2.265 |

窗口首块已经热身，并非上电首块；冷启动、复位后和15→1回绕仍需32768拍清表，只是每拍时间缩短。8192点/125Hz仍需65.536秒采集积累，提高电路时钟没有改变该积累延迟。

## 新增拍数与真实设备收益

| 配对记录 | 旧工作拍数 | 新工作拍数 | 多出拍数 | 按实际频率折算工作时间减少 |
|---|---:|---:|---:|---:|
| 家庭电力 | 879,135 | 901,106 | 21,971 | 23.13% |
| 家电/照明 | 1,085,352 | 1,097,615 | 12,263 | 24.15% |
| 波形 | 8,043,374 | 8,196,497 | 153,123 | 23.57% |

全部55份/1614块：旧匹配器工作325,283,888拍，新版332,132,849拍，多6,848,961拍；按实际频率折算从6.505678秒变为4.981992秒（少23.42%）。逐块保持相同源CRC、令牌CRC及探测次数，新增工作拍数介于0与该块探测次数之间。该值是设备工作计数，含清表/零填充/哈希/控制，不是纯匹配算术或全板忙碌率，更不是等量整机耗时减少。

## 面积、缓冲与验证

| 资源 | 旧版 | 新版 | 增量 |
|---|---:|---:|---:|
| LUT | 5318 | 5327 | +9 |
| 寄存器 | 7871 | 7866 | -5 |
| BRAM36等效 | 36 | 36 | +0 |
| DSP | 0 | 0 | +0 |

CMA仍196744字节，32位流、18位DMA BTT和单块最多8192点不变。没有增加核心数量、改用固定Huffman、降低预算、跳过候选或共享跨块历史。没有测功耗、ASIC/PPA、CPU空闲率及整板忙碌率；静态资源也不能与包含Rice的正式设计直接按面积差比较。

两种RTL分别301核心块/134完整AXI块、等待种子0/1/17：逐字节令牌、包、CRC、序号、TLAST、探测次数相同，逐块清表次数也相同。显式污染RAM、哈希/冷清表/回绕清表中断、持有输出及超长输入覆盖。独立BRAM综合与完整实现通过；时序报告约束使用实际频率。

另有定点复位专项：1000字节恒值输入先完成258字节比较，在新增FINAL_LENGTH状态直接复位，下一块完整冷扫32768项并输出6个已知独立字面量。33个比较拍逐拍核对全部8个bank的新地址等于通用地址公式、比较索引按8对齐并实际到达256。该专项独立保存日志和源码哈希。

实板42组支持测试、55份/1,614块/11,972,466点、134边界、12非法输入、11故障重载、两槽生命周期/迟到完成/关闭保护及6块慢sink混合流全部通过；另在15个成功块后的回绕第16块提交中断，确认DMA复位后重载并成功17块，32个成功包独立核对。实板中断不声称精确到某个内部FSM时钟；内部清表中途复位由仿真明确覆盖。

下载后在电脑独立加载源数据、展开令牌、逐点恢复、检查CRC/序号、对照冻结C/zlib规则，55个完整文件和736个配对包逐字节通过。输出字节不变，因此独立DEFLATE候选空间节省仍为家庭电力50.03559%、家电79.65290%、波形61.26747%；这些不是与Rice合并后的最终作品总值。55份仍为开发回归，无新增独立泛化集或实体ADC。

结束后新进程加载direct-frame-v1并实际处理完整power01，核对冻结SHA与两路DMA安全状态。正式161个文件及全部前序资格清单的源码/产物哈希保持。

## 停止点

第6轮完成，汇报后停下。下一项为紧凑令牌与DMA固定成本/批处理的独立评估，尚未开始；只有用户下一次“知道了”才继续。

证据：[独立审计](verification.json)、[全量板测](board/summary.json)、[七轮配对](board/paired.json)、[实际频率和时序](hardware/build-manifest.json)、[RTL差异](rtl-diff.patch)、[复现说明](../../lz77_hw_clock/README.md)。
