lirushirealone/sensor-lossless-fpga/evidence/collaboration/lz77-entropy-v1/report.md

# LZ77分支：令牌编码计时与结果返回优化

2026-10-19，以电脑日期为准。新版本lz77-entropy-v1为隔离实验；常规版本仍为direct-frame-v1，测试结束已恢复。

本轮只将正常TokenConsumer.pack返回结果的ctypes数组切片→Python整数列表→bytes，改为ctypes.string_at按实际长度复制为自有bytes。原Python参数检查、C令牌检查、分配/初始化、逐令牌tally、动态/固定Huffman、drain与校验、帧和原始回退均保持。FPGA仍为同一lz77-hw-v2、50MHz，输入驱动、DMA与统计读取不变。

## 实际完整分支：7轮配对

同板每通道前8192点，家庭电力4通道、家电2通道、波形4通道。热身一轮排除，随后7轮交替先后；两版使用同一输入驱动、冻结C库、硬件、verify_one函数及完整帧边界。表中为各组逐块完整时间之和的中位数，包含输入检查/快照/准备、DMA、结果解析、令牌编码与组帧；排除加载、热身、文件I/O和独立参考/展开/解码。

| 片段 | 旧完整分支ms | 新完整分支ms | 完整耗时减少 | 旧令牌编码ms | 新令牌编码ms | 编码耗时减少 |
|---|---:|---:|---:|---:|---:|---:|
| 家庭电力 | 64.123 | 55.429 | 13.56% | 16.873 | 8.488 | 49.69% |
| 家电/照明 | 27.941 | 25.928 | 7.20% | 4.260 | 2.433 | 42.89% |
| 波形 | 66.248 | 59.008 | 10.93% | 13.918 | 7.238 | 48.00% |

## 与同输入准备的纯ARM对照

| 片段 | 新FPGA＋ARM分支ms | 纯ARM分支ms | 新分支/ARM耗时 |
|---|---:|---:|---:|
| 家庭电力 | 55.429 | 45.363 | 1.222× |
| 家电/照明 | 25.928 | 21.764 | 1.191× |
| 波形 | 59.008 | 53.791 | 1.097× |

当前代表片段中新分支仍未全部快于同步优化的ARM，不能把局部编码提速称为整机已经胜出。

硬件工作周期、探测次数与获选完整帧长度在两版中严格相同；收益来自主机结果复制，不能称为新硬件计算提速。ARM仍轮询DMA，未测CPU空闲率。

## 为什么先改返回复制

先读取旧阶段实际保存的10个FPGA返回包，在板卡上做CPU诊断；不加载FPGA。每包100次C分段，另有7轮不带C计时桩的完整消费者配对，以及5种长度的独立复制对比。下表是各组按通道中位数求和的诊断值，不能与完整分支表直接拼接为互斥阶段。

| 片段 | 旧消费者ms | 直接复制消费者ms | 旧返回构造ms | C初始化＋释放ms | C tally ms | C建树/位流ms |
|---|---:|---:|---:|---:|---:|---:|
| 家庭电力 | 16.437 | 8.058 | 8.451 | 0.145 | 2.146 | 3.217 |
| 家电/照明 | 3.935 | 2.171 | 1.824 | 0.069 | 0.424 | 0.814 |
| 波形 | 13.123 | 6.554 | 6.671 | 0.136 | 1.583 | 2.782 |

代表片段的热运行中，初始化/释放约占旧消费者0.9%～1.8%，旧返回列表转换约占一半。因此本轮先落地返回字节复制；C上下文复用留作低收益候选，不按未经测量的0.5～1ms目标重写状态管理。tally和建树是仍然存在的实际编码工作。完整7阶段C原始记录、Python检查/调用区间与返回构造均保留。

| 复制字节数 | 原列表路径微秒 | string_at微秒 | memoryview复制微秒 |
|---|---:|---:|---:|
| 1024 | 261.156 | 15.992 | 8.287 |
| 4096 | 1031.863 | 18.526 | 10.211 |
| 16384 | 4182.214 | 30.626 | 19.617 |
| 32768 | 8380.648 | 47.562 | 34.461 |
| 65536 | 16847.162 | 95.306 | 82.731 |

两种直接字节复制均明显快于整数列表。选择显式长度的string_at形成自有bytes；memoryview复制在微基准更快，当前两者差值很小，未把其微基准差异外推成整机收益。参考编码中的其他列表返回没有混入本次正常路径收益。

oracle计时只作为辅助：输入是同一份16384字节残差，计时包含C参考匹配器分配/清表/复制/匹配/释放与工作计数，不是纯匹配内部时间；因此不由它单独判定整机差距归因。下表按通道中位数求和，不能直接作为同边界加速比。原始数据见profile/oracle.json。

| 片段 | C oracle完整调用ms | FPGA匹配器工作ms |
|---|---:|---:|
| 家庭电力 | 24.540 | 19.587 |
| 家电/照明 | 14.166 | 10.705 |
| 波形 | 31.317 | 24.603 |

## 全量诊断与正确性

| 数据 | 新完整分支s | 输入准备s | DMA提交至完成s | 令牌编码s | 最终组帧s | 纯ARM分支s |
|---|---:|---:|---:|---:|---:|---:|
| 家庭电力 | 0.362140 | 0.081742 | 0.180363 | 0.056771 | 0.002465 | 0.247379 |
| 家电/照明 | 0.065660 | 0.017208 | 0.035996 | 0.006480 | 0.000355 | 0.050664 |
| 波形 | 20.926628 | 5.511218 | 10.896575 | 2.663033 | 0.103401 | 16.790197 |

该表为本次全55记录单次诊断，不与此前跨日期运行作稳定收益比较。DMA区间包含设备收数、计算和输出，不是纯搬运；FPGA周期是其内部计数，不能再相加或直接相减归因。

电脑7组消费者测试、板卡14组消费者/输入测试通过。55份真实记录、1,614块、11,972,466点全部通过板上及下载独立核验；55个完整候选文件逐字节等于冻结8192点参考。38个边界、12类非法输入不触动DMA、4类DMA/主机故障重载通过；配对160包实际令牌及完整帧全部核对。自有bytes在scratch与输入复用后仍保持有效。

空间节省保持：独立DEFLATE分支家庭电力50.03559%、家电79.65290%、波形61.26747%，包含24字节头、尾块和原始回退；这不是与Rice择优后的竞赛系统总值。

FPGA仍5268 LUT、7868 FF、32 BRAM36等效、0 DSP、50MHz；bit/hwh与lz77-hw-v2相同，CMA仍98372字节。未测进程总RAM、功耗或整板忙碌率。常规direct-frame-v1的161个文件与此前各阶段冻结源码/产物均保持不变。测试最后以新进程加载正式设计，完整power01冻结输出、逐点校验及两路DMA状态确认后才报告恢复。

本轮使用原开发/回归数据，没有新增独立测试集或实体ADC。当前仍为隔离LZ77分支，尚未合入原Rice候选与完整连续调度；8192点在125Hz仍需65.536秒采集等待。

## 下一步

基于新路径重新测驱动完成后的复制/解析/统计与输入准备，再设计双缓冲。保持算法、候选、原始回退、CRC和缓冲生命周期，不从局部比例直接承诺总收益。

证据：[独立审计](verification.json)、[7轮配对](board/paired.json)、[全量实测](board/summary.json)、[分段诊断](profile/summary.json)、[使用说明](../../research/LZ77_ENTROPY.md)。
