lirushirealone/sensor-lossless-fpga/evidence/collaboration/lz77-epoch-v1/report.md

# 第5轮：世代标签减少哈希头表清空

2026-10-19，以电脑日期为准。隔离版本lz77-epoch-v1；本轮完成后汇报并停下，等待用户“知道了”再做下一项。正式比赛入口仍为direct-frame-v1，新LZ77实验仍未接回Rice和最终竞赛调度。

## 改动与不变项

头表每项从14位位置变为4位世代标签＋14位位置。标签1～15依次使用，读到别的标签就按空项处理。复位/上电后的首块和15→1回绕块仍完整清32768项，普通块跳过清表。位置0仍为NIL，当前有效链指针只能来自本块已写位置，不沿旧链。没有依赖RAM初值或省略回绕处理。

八字节并行/预取、搜索预算、预测、令牌、AXI封装/外部端口、自适应固定/动态Huffman、CRC/统计、帧和原始回退不变。软件完全沿用上一轮紧凑数组＋双槽重叠，两边均用同一驱动和消费者；本轮只更换bit/hwh。

## 七轮新旧硬件配对：实际完整流

同板50MHz，三个完整记录含尾块（8、6、32块）。热身1轮排除，之后7轮交替加载新旧设计；每次测量前均验证一块热身，两种硬件都支付一次冷清表。时间直接测源迭代器至内存sink返回，含分块、输入快照/CRC、DMA/硬件、全部收包/统计、自适应编码和完整帧；加载、启动、写盘、独立参考及解码在计时外，活动块之间不穿插验证。CPU也用相同紧凑输入和自有快照。

| 记录 | 原头表完整ms | 世代头表完整ms | 耗时减少 | 新方案更快轮数/7 | 新方案/同条件ARM |
|---|---:|---:|---:|---:|---:|
| 家庭电力 | 44.806 | 42.277 | 5.64% | 7 | 1.139× |
| 家电/照明 | 40.539 | 36.739 | 9.37% | 7 | 1.006× |
| 波形 | 259.396 | 241.300 | 6.98% | 7 | 0.799× |

与ARM比值小于1才表示该记录在本边界更快，不能外推全部数据或实体采集。收益不保证每个输入、每次运行都相同，不与之前隔时刻或不同计时边界的结果直接相减。

| 记录 | 各轮耗时减少范围 | 原窗口首块ms | 新窗口首块ms | 新末次提交至流结束ms | 原始数据吞吐MiB/s |
|---|---:|---:|---:|---:|---:|
| 家庭电力 | 1.77%～7.33% | 12.060 | 11.490 | 3.446 | 1.559 |
| 家电/照明 | 8.09%～11.71% | 12.448 | 11.817 | 3.751 | 2.049 |
| 波形 | 5.36%～7.71% | 11.971 | 12.039 | 4.746 | 1.897 |

窗口首块已经经过热身，不是上电首块；上电、复位后和标签回绕的完整清表成本保留。长流每15块有1块清表，另外14块跳过。首块/短流、回绕时的尾延迟应按具体应用处理。8192点在125Hz仍需65.536秒采集积累。

## 能精确确认的硬件周期减少

核心和完整AXI仿真分别301块、134块，每组在原版/新版、种子0/1/17下比较。令牌、TLAST/包、CRC/序号和搜索次数一致。每个普通块工作计数恰少32768拍，即50MHz下0.65536ms；冷块保持不变。核心逐块清表写次数也核对为普通块0、冷块32768。

| 配对窗口 | 块数 | 普通块 | 冷/回绕块 | 匹配器工作周期减少 | 对应设备工作ms |
|---|---:|---:|---:|---:|---:|
| 家庭电力 | 8 | 8 | 0 | 262,144 | 5.24288 |
| 家电/照明 | 6 | 6 | 0 | 196,608 | 3.93216 |
| 波形 | 32 | 29 | 3 | 950,272 | 19.00544 |

55份真实数据还逐块与冻结v2同输入计数比较：1506个普通块、108个冷/回绕块，共少49,348,608拍，对应0.986972秒匹配器工作。此处是设备计数差，不是已经省掉同量整机墙钟；ARM编码与下一笔DMA重叠，不能把这些时间相加或直接从总耗时扣除。matcher_work_cycles仍包含清表、零填充、查找及控制，不等于全板忙碌率。

## 资源和时序代价

| 项目 | 原版 | 新版 | 增量 |
|---|---:|---:|---:|
| LUT | 5268 | 5318 | +50 |
| 寄存器 | 7868 | 7871 | +3 |
| BRAM36等效 | 32 | 36 | +4 |
| DSP | 0 | 0 | +0 |

完整设计仍50MHz，布局布线setup/hold余量0.209/0.007ns，通过时序门槛。头表加宽有真实的4块BRAM代价；软件双槽CMA仍196744字节，32位输入、18位BTT及最大包不变。未测功耗、CPU空闲率或整板利用率，静态资源不与含Rice的正式设计按面积直接比较。

## 复位、回绕和完整验收

RTL前导显式污染头RAM并复位打断哈希、冷清表、15→1回绕清表，还覆盖超长输入及持有输出。实板新增专项：成功处理15块后，在第16块已提交且接收DMA未idle时主机中断；确认reset、活动视图清理、失败实例禁用，再重载并处理17块穿过下一次回绕。下载32个成功包，逐点及周期核验首块/回绕块保留完整清表。实板中断不声称精确到某个FSM内部时钟，清表中途复位由仿真明确覆盖。

ARM42组软件支持测试，55份/1,614块/11,972,466点、134边界、12非法输入、11类故障后重载、两槽实际所有权/关闭保护/迟到完成和6块慢sink混合流通过。电脑下载后独立源加载、展开、逐点恢复、CRC/序号、冻结C/zlib令牌、55个完整文件和736个配对实际包全部通过，并重算中位数及逐块周期差。

完整输出字节及空间节省不变：独立DEFLATE分支家庭电力50.03559%、家电79.65290%、波形61.26747%，包含24字节头、尾块和回退；不是与Rice择优后整个竞赛系统的总值。55份仍是开发/回归数据，无新增独立泛化集或实体ADC。

结束后新进程恢复direct-frame-v1，实际处理完整power01、核对冻结文件和两路DMA。原161个正式文件和全部前序冻结源码与产物保持。新阶段源码、仿真、构建、板测与审计分别绑定哈希。

## 停止点

本项完成后停止，等待用户“知道了”。下一项拟研究实际关键路径的流水与频率，在新增拍数、面积、时序和完整吞吐之间做实测选择；80～100MHz仅是待验证目标，本轮没有开始。

证据：[独立审计](verification.json)、[全量板测](board/summary.json)、[七轮配对](board/paired.json)、[回绕专项](board/wrap-recovery.json)、[构建清单](hardware/build-manifest.json)、[RTL改动](rtl-diff.patch)、[实现与复现说明](../../lz77_hw_epoch/README.md)。
