lirushirealone/sensor-lossless-fpga/evidence/collaboration/lz77-pipeline-v1/report.md

# 第4轮：双缓冲与异步调度

2026-10-19，以电脑日期为准。隔离实验lz77-pipeline-v1，正式系统仍为direct-frame-v1。本项完成后汇报并停止，等待用户回复“知道了”再进行下一项。

两组CMA轮换、单线程和一笔活动DMA：FPGA处理当前块时准备下一块；收回并完整校验当前包/源CRC/统计后提交下一块，再由ARM编码当前块。返回tokens引用自有不可变bytes，下一次DMA不能改变它。没有并发启动两个硬件任务。原硬件、输入组织、搜索预算、令牌、自适应固定/动态Huffman、完整帧及原始回退保持。

## 七轮配对：实际完整流时间

power01 8块、appliances_energy 6块、bidmc01 32块，均使用完整记录与尾块。1轮热身排除，7轮按轮转/反转次序比较冻结串行、新拆分接口串行和重叠调度。三者同一bit/hwh、50MHz、紧凑源、BulkReturnConsumer与内存输出/记录回调。CPU采用相同紧凑源、自有输入快照、CRC、模16位差分与zlib6。

时间从源迭代器进入至内存sink返回，直接读取墙钟，包含切片、输入准备、传输及硬件、结果校验/统计、编码、组帧和相同轻量记录回调。文件加载、Overlay/C库启动、写盘及独立参考/展开/解码在计时外。验证不穿插于活动块之间。不同于此前逐块区间相加，只在本轮内部比较。

| 数据 | 冻结串行ms | 新接口串行ms | 双缓冲重叠ms | 相对冻结串行少 | 相对新接口串行少 | 重叠/同条件ARM |
|---|---:|---:|---:|---:|---:|---:|
| 家庭电力 | 57.267 | 59.061 | 45.589 | 20.39% | 22.81% | 1.252× |
| 家电/照明 | 49.683 | 51.044 | 40.373 | 18.74% | 20.90% | 1.114× |
| 波形 | 335.465 | 343.519 | 261.617 | 22.01% | 23.84% | 0.879× |

新接口串行用于显示拆分调用、票据及双槽管理的代价；真实重叠收益看相同接口的串行对照，也保留用户上一版冻结驱动。与CPU比值小于1才表示该代表记录在本边界更快，不能外推全部数据、实时采集或所有输入。

| 数据 | 重叠更快轮数/7 | 各轮相对冻结串行耗时减少范围 | 原始数据吞吐MiB/s |
|---|---:|---:|---:|
| 家庭电力 | 7 | 19.22%～22.54% | 1.446 |
| 家电/照明 | 7 | 17.93%～21.01% | 1.865 |
| 波形 | 7 | 18.49%～24.39% | 1.750 |

## 首块与收尾延迟

| 数据 | 冻结首块ms | 新接口串行首块ms | 重叠首块ms | 新接口串行末次提交至结束ms | 重叠末次提交至结束ms |
|---|---:|---:|---:|---:|---:|
| 家庭电力 | 11.174 | 11.313 | 12.240 | 3.175 | 3.474 |
| 家电/照明 | 11.529 | 11.682 | 12.397 | 4.365 | 4.277 |
| 波形 | 11.018 | 11.291 | 12.135 | 5.340 | 5.402 |

首块要先准备并提交下一块再编码，因此可能更晚；末次提交至流结束包含未隐藏的等待、编码与交付，不是纯设备延迟。短流/单块缺乏重叠机会，保留串行入口。这里不包含采集积累：8192点在125Hz仍需65.536秒。

## 重叠证据与计时边界

独立小规模诊断中，11次有下一笔已提交的编码入口里，11次读到接收DMA尚未idle；编码前后状态无错误，最终包和全部统计都通过。该诊断额外读取状态，不用于性能表。正常配对保存每块提交、主机观察完成、编码、帧和交付时间，核对下一次提交在当前完整收包之后、上一块编码之前，并确认两槽交替且最多一笔DMA。

拆分版dma_ns包含从提交到主机观察完成期间重叠的ARM工作，不能与编码相加，也不能相减后称为纯搬运。pending_encode_ns只表示下一笔已提交期间的编码区间，不保证全部隐藏在有效硬件计算下。未测整板利用率、CPU空闲率、功耗或独立总线带宽。硬件匹配工作拍数、探测次数、输入/输出字节和完整文件在各模式一致，收益来自调度。

## 内存与安全代价

FPGA保持5268 LUT、7868 FF、32 BRAM36等效、0 DSP、50MHz。CMA分配98372→196744字节，增加98372字节（约96KiB）；没有增加匹配核心、改变BTT或配置系统CMA预留。每份票据仍保留自有raw+命令6n+4字节，最多两槽输入及前块自有返回；这些数字不代表总进程RAM。

保留原transfer/wait缓存处理、完整包/源CRC及12次有序统计读取，读取当前统计后才提交下一块。错误reset确认后才丢活动视图并允许释放CMA；reset失败保留两槽，PC故障模拟覆盖此保护，未故意在实板制造reset硬件失效。过期/外来票据、重复提交、第三份输入和跨线程修改被拒绝。正常close拒绝活动事务，上下文退出先取消后释放。

来源、C编码、输出回调或KeyboardInterrupt失败会取消下一笔并禁用实例，需要重载。已经交付的部分流不自动回滚，应作为不完整输出处理。延迟观察时若DMA已完成，完成优先于超时；实际测试在超时之后回来仍正确收回完成事务。

## 全量验收

PC10组、ARM42组测试；55份/1,614块/11,972,466点、38边界、12非法输入、两槽实际复用/释放/源快照、11类故障后重载、6块随机/短块/尾块/慢sink混合压力通过。电脑独立展开、逐点恢复、CRC/序号、冻结zlib令牌与完整文件核对通过；另外1104个配对实际包与完整帧全部独立核对，重新计算中位数。

55个候选文件逐字节不变，含头、尾块和回退的独立DEFLATE空间节省仍为家庭电力50.03559%、家电79.65290%、波形61.26747%；不是与Rice择优后完整竞赛系统的总值。55份仍是已有回归数据，没有新增独立泛化集或实体ADC。

最终新进程恢复并实际运行常规direct-frame-v1，完整power01输出及两路DMA核对通过；原161正式文件和全部此前冻结阶段完整。独立实验仍未接回原Rice和完整竞赛连续调度，不自动替换正式默认入口。

## 停止点

本项完成后停止，等待用户“知道了”。下一项按路线图研究epoch懒清头表，先确认收益上限与标签/回绕/异常/BRAM时序方案，再单独仿真、综合及上板；本轮没有开始该项。

证据：[独立审计](verification.json)、[全量结果](board/summary.json)、[三模式配对](board/paired.json)、[真实重叠诊断](smoke/summary.json)、[接口与复现说明](../../research/LZ77_PIPELINE.md)。
