lirushirealone/sensor-lossless-fpga/evidence/collaboration/lz77-transport-study-v1/report.md

# 第7轮：紧凑令牌与DMA成本评估

2026-10-20，以电脑日期为准。版本lz77-transport-study-v1。本轮完成先行评估，没有产生新的整机加速实现：FPGA仍为上一轮66.67MHz同一bit/hwh，线上仍是LZT1/32位令牌，批量DMA与紧凑DMA均未实施。正式入口恢复为direct-frame-v1，报告后停下等待用户“知道了”。

## 决定

**下一轮优先验证2块小批量DMA，保留原32位令牌；暂缓把紧凑令牌接入FPGA。** 依据是回传量虽然可大幅缩小，但原有55份实际输出背压为0，当前CPU紧凑原型的CRC＋解码＋编码成本反而更高；主机提交、缓存同步与完成收尾具有明显的逐调用成本，批处理值得独立实测。这里只是优先级选择，没有保证批处理必然变快。

下一轮只做2块，再决定是否扩到3块。先定义完整的批次/块边界、序号、CRC、统计快照、TLAST和异常恢复契约，再仿真、布局布线、同输入消融、完整入口配对；不直接上SG或8块，不减少候选比较/校验、不降低压缩率。若以后继续紧凑格式，应先尝试一次native调用直接消费紧凑字节并生成Huffman，重新比较成本，避免先解码成uint32再过一次消费者。

## 令牌真实结构与传输量

55份旧实测/1614块/11,972,466点共有6,104,589个令牌：3,164,664个字面量、2,939,925个匹配。最大实测距离16356，其中210,699个大于8191；不能按8192点误当8192字节，也不能把所有匹配令牌压成2字节。原型保留完整合法距离和3～258字节长度。

| 数据 | 原32位回传字节 | 固定24位草案 | 分组标志草案 | 分组回传量减少 |
|---|---:|---:|---:|---:|
| 家庭电力 | 509,284 | 382,283 | 246,173 | 51.66% |
| 家电/照明 | 39,148 | 29,409 | 22,856 | 41.62% |
| 波形 | 23,921,572 | 17,953,723 | 12,530,843 | 47.62% |

合计24,470,004→12,799,872字节，少47.69%。这是FPGA回传令牌的体积，不是最终存储压缩文件。两草案暂按相同32字节尾部预算，新的线上版本/CRC/长度契约尚未实现；不能把此比例当作系统加速或新的文件空间节省。

原u32实际55份全部output_stalls=0，即采样测试中没有观察到有效输出被m_axis_tready挡住。不表示DMA、缓存或收包开销为0，也不说明其他负载永不背压；input_gap_cycles还含前端节奏/ready等等待，不能据此把全部收数空拍归因ARM饥饿。

## 计时夹具本身的扰动

两种模式使用同一个硬件、相同原驱动动作/输入/编码和完整帧。正常模式不插计时；诊断模式包装原transfer/wait、缓存函数、统计读取和状态轮询。1轮预热排除＋7轮交替，三个完整记录共736个实际包，完整字节均相同。此表衡量插桩扰动，不是优化收益。

| 代表记录 | 正常完整ms | 诊断完整ms | 诊断耗时增加 |
|---|---:|---:|---:|
| 家庭电力 | 38.111 | 41.997 | 10.20% |
| 家电/照明 | 30.992 | 33.600 | 8.42% |
| 波形 | 202.562 | 213.740 | 5.52% |

插桩干扰不可忽略，以下细分值是诊断状态下的区间量级，不能直接称为正常运行的精确固定成本或可消除收益。

| 满8192点块的诊断中位数µs | 电力 | 家电 | 波形 |
|---|---:|---:|---:|
| 主机submit整体 | 951.03 | 946.94 | 941.09 |
| 其中receive.transfer | 185.91 | 187.06 | 184.18 |
| 其中send.transfer | 414.65 | 414.58 | 410.83 |
| 其中输入flush | 214.37 | 212.19 | 210.22 |
| 完成后的send.wait | 138.97 | 141.60 | 139.15 |
| 完成后的receive.wait | 428.47 | 429.39 | 430.79 |
| 其中输出invalidate | 252.32 | 249.70 | 251.71 |
| wait返回后收包/CRC/统计/所有权 | 773.05 | 599.71 | 661.77 |
| 其中统计读取 | 140.65 | 141.18 | 138.61 |

表中“其中”是嵌套子区间，不能相加。轮询/等待和设备工作重叠，不用dma_ns减device时间冒充纯DMA。finish-after-wait包含实际快照、元数据CRC/解析、统计和状态更新，未进一步分出每一项，不能全算快照。各项中位数也不强求代数相加等于总中位数。

## 缓存同步与结果复制的独立微基准

这里没有活动DMA，使用同一底层CMA分配的不同长度视图。flush之前在计时外写脏输入；invalidate之前在计时外读热输出；copy生成自有bytes。每项排除1轮预热，7轮×20次。缓存均为非coherent。

| 字节数 | 输入flush µs | 输出invalidate µs | 自有输出copy µs |
|---|---:|---:|---:|
| 4096 | 145.09 | 149.83 | 27.38 |
| 16384 | 145.06 | 152.43 | 75.82 |
| 18464 | 145.07 | 151.79 | 84.38 |
| 32768 | 144.68 | 152.92 | 141.75 |
| 49184 | — | 153.20 | 207.14 |
| 65568 | — | 153.55 | 271.41 |

同底层分配的缓存同步请求几乎不随视图大小变化；这支持“不能按回传字节数线性估算收益”，但没有分离固定调用成本与后端整BO同步，也没有测真正缩小CMA分配后的收益。复制随长度增长。不能拿最坏65568字节的复制差直接套给典型实际包，更不能把这些微基准简单从完整时间扣除。

## 同板CPU回放：新增解码成本

55份之前保存的实际包，在ARM内存中生成/验证两草案，再交给同一个BulkReturnConsumer。两草案全部1614块还原为原uint32令牌，Huffman返回字节与原消费者相同。三个完整代表记录另做1热身＋7轮格式轮转。计时只含正文CRC、原token视图或受检C解码、相同Huffman消费者；紧凑编码、文件读取、FPGA/DMA与最终组帧在外。这是接收侧CPU微基准，不能声称整机因此慢了同样比例。

| 记录 | 原CRC/视图＋编码ms | 24位解码＋编码ms | 分组解码＋编码ms | 分组区间增加 |
|---|---:|---:|---:|---:|
| 家庭电力 | 11.815 | 15.741 | 15.106 | 27.86% |
| 家电/照明 | 6.388 | 8.719 | 8.599 | 34.60% |
| 波形 | 55.874 | 73.195 | 71.082 | 27.22% |

当前原型包含一次ctypes解码调用、新uint32数组分配、合法性检查，然后消费者再次验证/统计/编码。增加成本的具体C循环、分配和ctypes占比没有继续拆分，不归因某一项；直接消费紧凑字节的融合实现可能不同，本轮没有实现或证明其净收益。流水可能隐藏部分新增ARM时间，真正紧凑RTL也可能有打包/排队成本，只有端到端上板才能决定最终胜负。

## 最坏容量与小批量范围

| 草案 | 单块输入上限B | 单块输出预算B | 两槽CMA预算B | 单次BTT同时容纳的满块上限 |
|---|---:|---:|---:|---:|
| u32 | 32772 | 65568 | 196744 | 3 |
| u24 | 32772 | 49184 | 163976 | 5 |
| flags8 | 32772 | 18464 | 102536 | 7 |

BTT18位按262143字节核算。8块满输入262176字节已经超出；原u32的最坏输出每块65568字节，通用批次最多3块，不能按实际平均令牌数分配后赌数据可压缩。紧凑草案仅在当前32字节尾部假设下最多7块，尚不是可部署配置。

下一轮先2块、保留u32：输入65544字节、最坏输出131136字节，两槽约393360字节；若3块则输入98316、最坏输出196704，两槽约590104字节。均未算新批次头/边界目录/每块统计等附加内容，正式实现必须重算。现有simple DMA每个TLAST结束一笔传输；改批次TLAST、完整块目录、序号/CRC和计数器快照后才能共享一次事务，不是把当前数组直接拼接。批次还增加攒块/首块延迟与错误恢复复杂度，不承诺按1/批大小消掉开销。

## 验证与停止点

PC与ARM编解码边界测试通过。电脑独立Python解码全部两种紧凑流并核对55份/1614块原令牌；ARM同源回放也一致。另有原协议144个实际小/大/随机/恒值/斜坡块、计时夹具中断和缓存hook恢复、736个实际配对包/完整文件，下载后独立展开、逐点和CRC/序号/计数器核验。55份原始硬件数据来自上一轮，不冒充本轮重新跑了55份紧凑DMA。

最初测量夹具离线cache探测前未完成DMA首次传输，旧close保护正确拒绝释放；没有放宽保护，改为先完成一次正常传输再测。失败记录保留在harness-attempt-1，失败后同样实际恢复正式版。最终新进程实际运行完整power01，核对冻结文件SHA、161个正式文件和两路DMA安全状态；全部旧冻结源码/产物保持。

**本项评估完成后停止。等待用户下一次“知道了”才实施2块小批量，不提前改协议或硬件。** 原压缩文件和空间节省保持；没有新系统吞吐、实时LUT忙碌率、功耗、ASIC或独立泛化数据的结论。

证据：[独立核验](verification.json)、[原型和容量](pc/summary.json)、[板测汇总](board/summary.json)、[计时扰动](board/paired.json)、[ARM回放](board/replay.json)、[缓存微基准](board/cache-copy.json)、[复现说明](../../research/TRANSPORT_STUDY.md)。
