lirushirealone/sensor-lossless-fpga/evidence/collaboration/unified-v1/report.md

# 第9轮：Rice与LZ77统一正式版本

2026-10-21。版本unified-v1。本轮只完成四个剩余交付阶段中的第1阶段：整合完整系统。默认入口已切换至统一版，并通过新进程真实完整power01确认；旧direct-frame-v1和所有实验仍可回退。之后还剩独立数据/长时间稳定性、电脑图形界面、提交包/演示/复现3个阶段。

## 最终行为

**主要取舍：完整文件更省空间，但统一批2相对旧正式版的三个代表记录耗时增加48.04%、28.63%、30.74%，7轮均未更快。** 批2相对同一新实现批1仍有4.35%～13.70%收益；这些局部收益不足以抵消新增完整候选和整合成本。本版是功能/压缩效果的正式收敛，不宣称整机加速。旧快速入口保留可回退。

同一个Overlay同时包含原四路1024点预测/Rice/分组编码器和8192点LZ77。每个1～8192点任务完整计算原1024点混合方案、大块DEFLATE和原始回退，按全部最终帧的真实长度择优，不用估算长度或历史跳过。原小块方案逐块比较PL原生候选与ARM差分DEFLATE6，保留旧覆盖；大块匹配由PL执行，ARM负责自适应Huffman。仍有ARM小块匹配成本，不声称全部DEFLATE在FPGA。

原生获选可能产生多帧，大块或整任务raw获选产生一帧；最终文件序号按实际输出帧重新连续编号，与两个硬件内部序号分离。每帧独立解码，统一源CRC/元数据CRC、通道、点数、长度和原始回退。新UCF1文件头记录四通道总数，检测末尾整帧丢失；UHC1帧明确模式和块长，不混用旧FHC1解码器。

## 全量文件空间节省

按同一批原始int16字节总数加权：1−所有完整输出字节之和/所有原始样本字节之和。新输出计入每文件64字节容器头及所有24字节帧头；旧两方案没有这一64字节头，比较时不隐藏。下面是现有55份回归数据，不是新的独立泛化实验。

| 数据 | 旧正式1024混合节省 | 独立8192方案节省 | 新统一文件节省 | 新文件总字节 |
|---|---:|---:|---:|---:|
| 家庭电力5份 | 53.69010% | 50.03559% | 55.08247% | 155,235 |
| 家电1份 | 75.08487% | 79.65290% | 79.57183% | 16,126 |
| 波形49份 | 51.70362% | 61.26747% | 61.30711% | 9,100,719 |

每份新文件大小均不超过同数据旧正式1024混合与独立8192方案中较小者加64字节。比较的原小块候选与整任务候选点数一致、通道一致、原值一致，所有小块帧头求和；没有拿一个1024点帧与一个8192点帧直接比长度。raw只保证正文不膨胀，整个文件仍有容器/帧头，特别短数据可能扩大。

## 完整入口计时

同板1热身＋7轮轮转/反转：旧正式1024混合、统一批1、统一批2。统一两种分组计算相同候选，最终文件正文相同，仅文件头记录的批大小不同。旧与新算法覆盖/块长/硬件功能不同，因此旧新时间是完整作品代价比较，不当作同算法FPGA/优化C基线加速比。源在内存中，加载、bit加载、写盘、参考和解压核验在外；实际source迭代至sink、CRC、准备、选择及轻量取证回调在内。

| 代表完整记录 | 旧正式ms | 统一批1ms | 统一批2ms | 批2较旧耗时减少 | 批2较批1减少 | 胜旧轮数 |
|---|---:|---:|---:|---:|---:|---:|
| POWER | 70.776 | 121.413 | 104.779 | -48.04% | 13.70% | 0/7 |
| APPLIANCES | 72.812 | 106.315 | 93.656 | -28.63% | 11.91% | 0/7 |
| BIDMC | 464.423 | 634.810 | 607.188 | -30.74% | 4.35% | 0/7 |

正数是耗时减少，负数表示增加。统计来自三个完整代表记录，不保证所有输入提速。两路设备计数、DMA提交到主机观察完成和ARM编码有重叠，不能相加或用相减推断纯DMA成本。独立LZ77阶段的时间不代表本版新增Rice/旧小块候选后的整机时间。

## 硬件和内存

完整布局布线LZ77实际66.666667MHz、Rice50MHz，HWH为66.666672/50.000000MHz；setup/hold 0.247/0.023ns。GP0控制互连自动跨域，HP0/HP1各供一引擎；CDC报告双向各30端点、共60全部Safe，无Unsafe/Unknown。两个核心RTL保持原冻结字节，仅重新布线集成。

LUT20669/53200（38.85%），FF24515/106400（23.04%），BRAM36等效49/140（35.00%），DSP0。原正式版的预测成本查询模块不再参与本方案，因此已移除，不把旧新资源差当作相同功能优化。资源百分比是设计占用，不是实时忙碌率。

LZ77两槽393624字节＋Rice两槽98824字节，CMA合计492448字节。它不是进程总内存；另有最多两批源/命令、子块快照、自有结果、Huffman状态及调用者数据。内部不无限积累结果，调试取证回调会在计时外保存文件。板上独立诊断实际观察到两笔接收DMA同时未idle，证明两个引擎真实共存并运行。四路原生核心保留，实际同时活跃数受每批通道分布限制，不声称四路始终满载。

8192点采集累积等待仍存在，批2可能还需等待另一任务。默认批2为回放吞吐入口，批1可选；本版没有实体ADC持续采集、功耗、ASIC或实时性的实测保证。

## 验证和实际入口

12组新增PC测试及ARM合计64组通过。双时钟并行仿真三种等待条件，保留Rice191包/467帧与LZ77的134块/77批及原背压、非法输入和复位；字节不变。实板134边界、55份/11,972,466点、1,614任务和11,784原生候选全部通过；9类双引擎故障重载确认两路都停止、清除活动DMA视图并在reset确认后释放缓冲，PC另覆盖reset失败保留。

电脑独立核验全部下载文件、候选、真实LZB1和Rice DMA字节/目录/统计/CRC，以固定zlib1.2.11 C参考重新编码大小并重算最终逐帧择优；原生候选匹配冻结1024方案，所有实际原生候选及最终文件均完整解码对源值。正式验收不抽样。最初测试夹具只有10份旧原生板测参考，BIDMC05处停止；失败及原正式版恢复证据保留于harness-attempt-1。随后使用此前55份LBC1原生1024参考，仅规范化magic/头CRC，全部逐点恢复对源，另与旧10份实际DMA负载核对；算法和RTL未因此改变。

第二次夹具在55份及9类故障全部通过后，于旧版配对文件比较处停止：旧版通道序号跨文件延续，而冻结单文件从1开始。harness-attempt-2保留全部证据。修正方式只在计时外规范化旧版序号/头CRC，再比完整负载与冻结文件；保存原始旧位流和初始序号供独立核对。复用了已通过的55份实际DMA文件，没有把它们冒充新跑；未保存的55份整流墙钟明确标记为不可用，不用分段计时拼凑。新鲜双引擎并行/故障取证与7轮配对单独完成，所有本文性能数字只来自该配对。

命令入口board/run_unified.py已实际压缩完整power01，再用同入口解压NPZ并逐点核对。文件先写.part、验证后改名，已存在输出拒绝覆盖。无需Jupyter；板上执行压缩，电脑也可执行纯软件解压。图形界面还未制作，属于后续阶段。详见[使用与格式](../../research/UNIFIED_SYSTEM.md)。

独立审计通过后，再由新进程加载统一Overlay，实际处理完整power01并核对冻结本轮文件SHA、两个DMA安全状态、当前bit/HWH及入口绑定，最后把统一版留在板卡上。旧正式版和12个前序阶段不覆盖，已重算所有冻结源/产物保持一致。

**本轮已完成并停下。等待下一次“知道了”才开始独立数据和长时间稳定性；不提前制作界面或最终提交包。**

证据：[独立核验](verification.json)、[正式启用核验](activation-verification.json)、[板测汇总](board/summary.json)、[完整计时](board/paired.json)、[硬件资源](hardware/build-manifest.json)、[双时钟仿真](simulation/summary.json)、[原生参考55份](golden/summary.json)。
