lirushirealone/sensor-lossless-fpga/evidence/collaboration/unified-validation-v1/report.md

# 第10轮：独立数据与连续稳定性验收

2026-10-21。正式产品仍为unified-v1；算法、全部候选、RTL、驱动、格式及bit/HWH没有改变。本轮是验收，不增加压缩率或宣称整机提速。结束时由新进程实际重载正式目录中的bit，完整power01输出与已冻结正式版本一致，两路DMA均idle且无错误。

## 事先固定的独立数据

下载和压缩前固定[protocol.json](protocol.json)：MIT-BIH1.0.0的100/101/102全部原始双通道；ECG-ID1.0.0前6人首份记录，保留其原始与数据集自带滤波两路。不是随机抽样，不剔除任何差结果，没有按压缩率挑片段、重新滤波、缩放、截断或量化。共9份、4,020,000个通道样本。

原始WFDB16/212数字值准确解包到int16；每份官方SHA256、原始首值和通道checksum均验证，电脑再用独立标量方式解包全部采样并比较。212是每样本12位的文件容器（MIT-BIH采集分辨率为11位），不是把浮点物理量重新量化。完整记录均无裁剪。来源与许可随[data manifest](../../data/unified-holdout-v1/manifest.json)保存。

- [MIT-BIH原始数据与引用](https://physionet.org/content/mitdb/1.0.0/)，DOI10.13026/C2F305；Moody与Mark，The impact of the MIT-BIH Arrhythmia Database，2001，DOI10.1109/51.932724。
- [ECG-ID原始数据与引用](https://physionet.org/content/ecgiddb/1.0.0/)，DOI10.13026/C2J01F；Lugovaya，Biometric human identification based on electrocardiogram，2005硕士论文。
- 两者页面声明ODC-By1.0。原始数据页和相应完整许可页面均随数据保存。下载使用PhysioNet官方公开AWS镜像，文件与原站SHA256一致。

**局限：新增的是两组生理波形数据，不是新增电力数据；也没有证明对所有传感器、病种或人群的代表性。原电力/家电仍为回归测试，不能把它们称作新独立泛化证据。**

## 新数据完整文件空间结果

均计入64字节UCF1和全部24字节帧头；加权节省=1−完整输出字节总和/对应输入字节总和。先列本系统int16接口基准，同时列原WFDB数据文件基准；不计原站头文件/注释文件，二者都不把数据集附带人口信息当作输入。MIT-BIH原本有12位打包，两个百分比必须区分。

| 新数据 | 原始int16字节 | 原WFDB数据字节 | 完整输出字节 | 相对int16节省 | 相对原WFDB节省 |
|---|---:|---:|---:|---:|---:|
| mitdb | 7,800,000 | 5,850,000 | 2,047,366 | 73.75172% | 65.00229% |
| ecgiddb | 240,000 | 240,000 | 62,718 | 73.86750% | 73.86750% |

| 固定记录 | 输出字节 | 相对int16节省 |
|---|---:|---:|
| mitdb-100 | 688,318 | 73.52623% |
| mitdb-101 | 642,831 | 75.27573% |
| mitdb-102 | 716,217 | 72.45319% |
| ecgiddb-Person_01-rec_1 | 8,018 | 79.95500% |
| ecgiddb-Person_02-rec_1 | 10,151 | 74.62250% |
| ecgiddb-Person_03-rec_1 | 12,003 | 69.99250% |
| ecgiddb-Person_04-rec_1 | 10,988 | 72.53000% |
| ecgiddb-Person_05-rec_1 | 10,402 | 73.99500% |
| ecgiddb-Person_06-rec_1 | 11,156 | 72.11000% |

新增9份记录的504个大任务选择统计为{'legacy1024': 504}；其中小块最终帧模式为{'3': 2260, '1': 707, '2': 960, '4': 3}（1～4原生PL、5为ARM小块DEFLATE）。这批新数据全部由原1024混合候选胜出，大块LZ77候选仍实际完整计算，但没有为这9份文件再节省字节。此前55份中仍有大块候选胜出，不能据单一新数据方向删除或宣称普遍优劣。

新增数据批2的实际Rice事务max_active_lanes分布为{'2': 495}，均为2路同时活跃。四个物理原生核心仍驻留，但2任务分组和本批双通道数据没有让4路全部同时工作；不能把设计含4核称为全程4核满载。

批1和批2均独立运行全部9份，最终正文完全相同，仅文件头的分组字段及CRC不同。电脑重算所有真实候选、完整帧成本和平局规则：原生各1024子块、ARM小块差分DEFLATE、大块PL令牌＋Huffman和raw均保留；所有实际LZ令牌另与同规则独立C oracle一致。未改变算法或搜索预算。

## 边界、供数、损坏与恢复

两种分组各覆盖空文件、单通道全幅边界、缺通道/长度不平衡、四路随机、混合可压缩程度、1点文件；包含1023/1024/1025/8191/8192/8193/16385长度和尾批。慢source、慢sink、生产者重复使用同一个可变输入缓冲各在两种分组实跑。逐点/源CRC/元数据CRC/序号/总数全核对，验证快照在上游复用前已拥有数据。实际等待单列保存，不称作硬件计算。

9类损坏文件：文件头截断、帧内截断、完整末帧丢失、载荷翻位、元数据翻位、尾部垃圾、重复帧、重算CRC后的错误序号和错误总数；正式解码器与电脑独立解码器均拒绝。9类双引擎故障/中断及重载恢复沿用冻结测试：坏LZ/Rice头、两路源CRC错误、source/sink/consumer/observer异常、主机中断。确认两路均安全复位后释放活动视图，再实际重载处理小文件。reset失败留存缓冲的机制沿用上轮独立单元证据，本轮没有伪造物理reset失败。

全55份旧正式回归再次实际运行，11,972,466点全部对源，完整文件SHA与第9轮一致。每份新文件均按完整候选成本择优，raw只限制正文膨胀；随机和短数据会因文件/帧头而扩大，空文件为64字节。

| 人工边界数据（批2） | 原始字节 | 文件字节 | 节省 |
|---|---:|---:|---:|
| empty | 0 | 64 | 不定义 |
| single_channel_extremes | 32,770 | 263 | 99.19744% |
| missing_unbalanced_channels | 18,434 | 227 | 98.76858% |
| four_channel_random | 36,864 | 37,024 | -0.43403% |
| mixed_compressibility | 65,536 | 16,662 | 74.57581% |
| one_sample | 2 | 90 | -4400.00000% |

## 30分钟持续回放

先热身2个完整周期，然后在同一进程、同一Overlay、同一组492448字节CMA缓冲中连续运行1806.016秒，完成152个全周期、2,280个完整文件、79,040个大任务、599,792个最终帧，逐点验证622,714,056个通道样本。错误0。循环没有人为sleep，达到1800秒后完成当前全周期再结束，没有提前截断记录或换板重启。9份固定新数据＋6种人工边界按固定顺序重复；反复回放不增加独立样本数量。

每次都独立逐帧解码并与源逐点比较，验证CRC/序号/总点数/所有权及完整候选大小界限；每个完整输出另外与首次通过电脑独立审计的同文件SHA相同。长跑不保留全部输出字节，保存每文件哈希、全计数及连续日志哈希链；首次验收的每个候选和真实DMA码流完整留存。不能声称已下载全部长跑DMA数据到电脑重新解码。

原始int16累计1,245,428,112字节，完整输出累计328,990,928字节。整个循环有效输入速率0.689600MB/s，包含独立验收负担，不用于与上一轮正常产品速度直接比较。compress_stream累计1746.452秒（包含回调）；其内逐点验证累计223.244秒；外层压缩调用累计1747.115秒。日志、GC和内存检查在调用外；嵌套计时不能相加，也不把减法当作无校验产品基准。

LZ设备各包total_cycles累计折算404.865秒，包括设备收数/匹配/输出，不能称为纯匹配或与Rice/主机区间互斥相加。30分钟是完整验收回放墙钟，不是30分钟FPGA全程忙碌。慢供数/慢sink另做6次，不混入长跑。

热身后RSS84,956KiB，结束86,252KiB，变化+1,296KiB；周期终点RSS范围85,024～86,252KiB，整个进程VmHWM为101,240KiB。通过原先固定的RSS末端增量≤8192KiB。热身后全系统CmaFree22,032KiB，结束19,380KiB，减少2,652KiB；原全系统CmaFree损失≤1024KiB诊断结果为False，该门槛已公开撤回，不能写作原全部内存门槛通过。

实际DMA门槛采用公开修订：新进程构造前0个renderD128映射，构造后及每个周期始终8个、共524288字节；虚拟范围与四槽的物理DMA输入/输出地址从构造、热身到结束完全一致；close后返回0个映射。492448字节是数组视图声明长度，按4KiB页面取整的真实映射为512KiB，二者不同。没有在长跑中清缓存、压缩/重整系统内存、重启进程或重新分配缓冲。此证据支持本负载30分钟内实际用户态DMA映射与生命周期稳定，不证明无限运行或排除所有内核层泄漏。全系统CmaFree下降的具体来源未完全确认，继续保留诊断，不把它笼统归因于缓存。RSS/CMA/设计资源数都不是实时FPGA利用率。

## 内存验收方法的公开修订

最初连续运行约11分钟，数据核对无错、RSS保持稳定，但全系统CmaFree下降；原1024KiB末端阈值不能单独度量本压缩进程的DMA分配。主动正常中断该轮并保留harness-attempt-2-memory-metric日志，该轮不算完整30分钟验收，也不判定原内存条件通过。只读检查实际有8个映射、512KiB；系统未提供CMA debugfs，XRT memstat显示不可能的数值，因此均未用于断言分配量。

随后在新的完整确认试验之前写入[endurance-amendment-v2.json](endurance-amendment-v2.json)，明确这是观察结果后的方法修订，未改原protocol.json或数据选择。用实际映射/物理地址恒定和close后释放替换全局空闲量门槛，RSS/所有数据与30分钟要求保持；重新热身后从0计时完整1800秒，最终数据和全部检查点先落盘再判定，避免失败时丢失端点。本文30分钟数字全部来自这次新鲜确认，不拼接前次11分钟。

Linux官方把CmaFree定义为整个CMA预留区中空闲的内存，不是某进程已分配字节：[Linux proc文档](https://www.kernel.org/doc/html/latest/filesystems/proc.html)。实际内核debugfs没有可用分配位图，[CMA debugfs官方接口](https://docs.kernel.org/5.15/admin-guide/mm/cma_debugfs.html)仅作接口依据，不冒充实板已获取的证据。

## 校验工具与保留证据

第一次验收用原Python标量解码器重复核对全部原生候选，100/101通过，102在额外候选解码时被有意正常中断；上下文安全关闭并保留harness-attempt-1的源码、清单、控制台和实际文件。该次不算完整验收或长跑。加速版只为验收新增独立C位流解码器，原产品源码未改。PC和ARM都先用1395帧（全部5模式、边界和真实100记录）与原标量解码逐点交叉一致；正式验收仍对每个输出采样完整解码。电脑再用原标量解码和原编码参考独立核对全部保留的新实际候选，不抽样。

新工具节约验证时间不当作产品加速。原PhysioNet主站下载缓慢及外部许可URL403没有改变记录选择；使用官方AWS镜像，许可改从数据页面对应正式view-license页面保存。早期下载产物保留download-attempts。两次路径/命令处理问题发生在工具准备阶段，未当作压缩产品故障；所有最终门槛均需新鲜完整通过。

板卡系统日期不正确；实验标记采用客户端2026-10-21，持续时间均取单调时钟，不按板卡文件修改日期推算时间。没有实时ADC、功耗、ASIC/PPA实测，本轮没有进一步电力外部数据，也没有证明所有输入压缩率必然提高或统一版速度超过旧版。上一轮统一正式系统29%～48%的代表记录时间代价仍成立。

## 状态与下一步

正式版本仍为unified-v1，正式资格不改写，仅在CURRENT_VERSION追加本轮验收资格链接。13个前序冻结版本全部重算源/产物哈希保持一致。实际重载正式bit并完整power01核对后停下。

**本轮完成，等待下一次“知道了”才制作电脑操作界面。还剩2阶段：电脑图形入口；提交包、演示与干净环境复现。**

证据：[预注册规则](protocol.json)、[独立源解包](source-verification.json)、[新数据/边界与55回归](board/acceptance.json)、[电脑候选审计](acceptance-verification.json)、[连续运行](board/endurance.json)、[逐文件哈希链](board/endurance.jsonl)、[正式恢复](board/formal-restoration.json)、[最终独立核验](verification.json)。
