lirushirealone/sensor-lossless-fpga/skill/prompt_workflow.md

# 从真实开发过程提炼的提示词工作流

以下为2026年11月1日整理的可复用模板，不是历史原话。原始提示词和模型回答见report/ai_records；效果依据仅为列明的历史案例，不代表这些新模板在所有新题目上已经验证。

## 性能归因与单项优化

来源c01、c02、c06。填写输入表示、通道、分块、工具版本、实际时钟、每个计时器的起止和嵌套关系。

> 请区分实测、推断和待测；先指出当前计时中不能相加或相减的区间。给出初始化、检查、频次统计、实际编码、结果构造的测量方法，并测插桩扰动。只建议一项能冻结完整输出字节的改动，用相同输入准备、多轮交替的完整入口确认净收益；不要先承诺节省多少毫秒。

验收：原样输出、逐点恢复、边界一致、首尾延迟与内存代价同时记录。失败包括把整包当匹配、把少字节直接当加速、把采样点当输入字节。

## DMA所有权与异常恢复

来源c03、c07、c09。填写协议、槽数、状态机、缓存属性、最大输出和复位确认条件。

> 请先列出每个输入、CMA视图、返回字节和ticket的拥有者及有效期，再设计重叠。覆盖过期ticket、迟到完成、消费者异常、下一笔已提交、中断及复位失败；确认设备停止前不能释放缓冲。对并行完成顺序与稳定载荷分别比较，保留失败记录。

验收：活动缓冲不提前释放，失败不发布成功文件，新会话黄金样例通过；模拟和实板证据分开。

## RTL资源时序与有限代价

来源c04、c05。填写目标器件、时钟、真实关键路径、存储映射及可能新增周期。

> 请提出保持搜索规则和输出的局部修改，覆盖冷启动、复位、标签回绕和背压。先做功能仿真，再完整布局布线；请求频率不是实测频率，未通过的目标必须保留为失败。比较LUT、FF、BRAM、时钟、新增周期与完整入口耗时，不能只报核心拍数。

验收：输出与参考一致、时序非负、实际时钟确认，面积和长尾代价公开。

## 数据独立性与复现交付

来源c08、c09、c10。填写数据集选择规则、数字表示、许可、独立测试时间点和安装平台。

> 请在观察结果前冻结新数据和验收规则，区别原文件字节与接口字节；保留全量无损检查与负例。把系统统计、进程内存和真实DMA映射分别列出，撤回门槛须记录并重新完成完整试验。交付时在新目录和独立环境执行，验证源码移动、重复安装、损坏拒绝和历史保留。

验收：不按结果筛除数据，不将重复回放算作独立样本，不把一台机器的新环境称为第二台实体机验收。SHA清单只验证完整性，不代替来源认证。
